datamaskinprojektet/PCB/main_schematic/Grafikk/main_schematic-brd.png

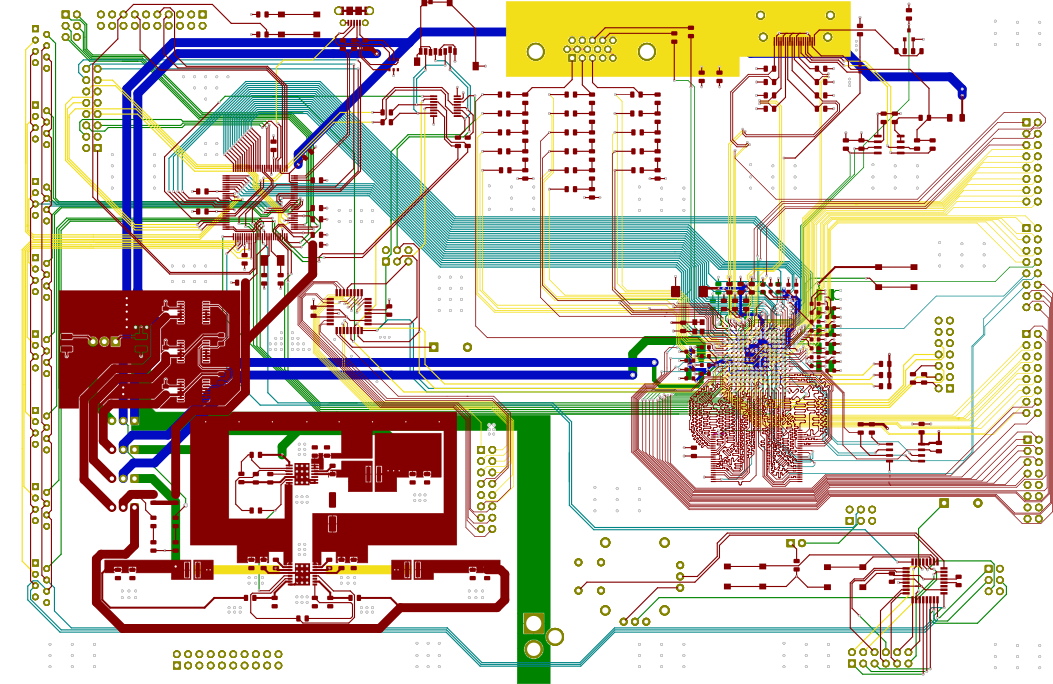
main_schematic/Grafikk/main_schematic-brd.png
