datamaskinprojektet/PCB/README.md

## Useful links:
[Kicad Library mangement](https://hackaday.com/2017/05/18/kicad-best-practises-library-management/)
[Kicad git integration](https://jnavila.github.io/plotkicadsch/)
