datamaskinprojektet/PCB/harwareTest/harwareTest.runs/impl_1/.init_design.begin.rst

<?xml version="1.0"?>
<ProcessHandle Version="1" Minor="0">
    <Process Command=".planAhead." Owner="Viktor" Host="DESKTOP-4Q16636" Pid="52436">
    </Process>
</ProcessHandle>
