datamaskinprojektet/PCB/Controller/Controller/ControllerTop.stl

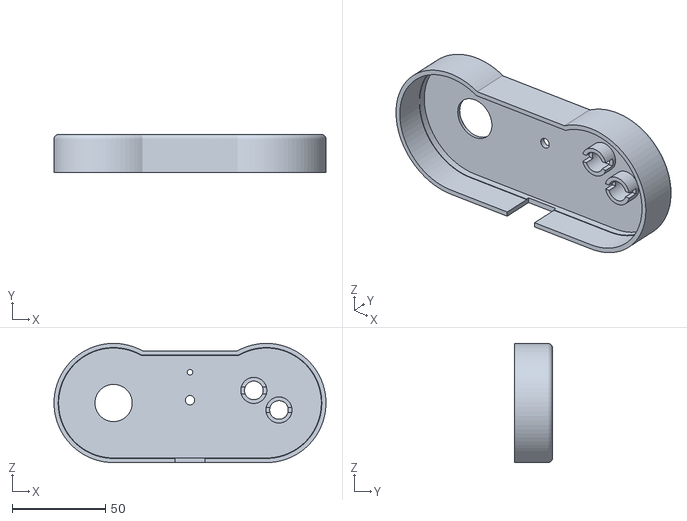
[picture p2: CAD file, 2020-11-24]
Controller/Controller/ControllerTop.stl
146.0 x 20.5 x 64.0
