datamaskinprojektet/PCB/ControllerBetterPrint.stl

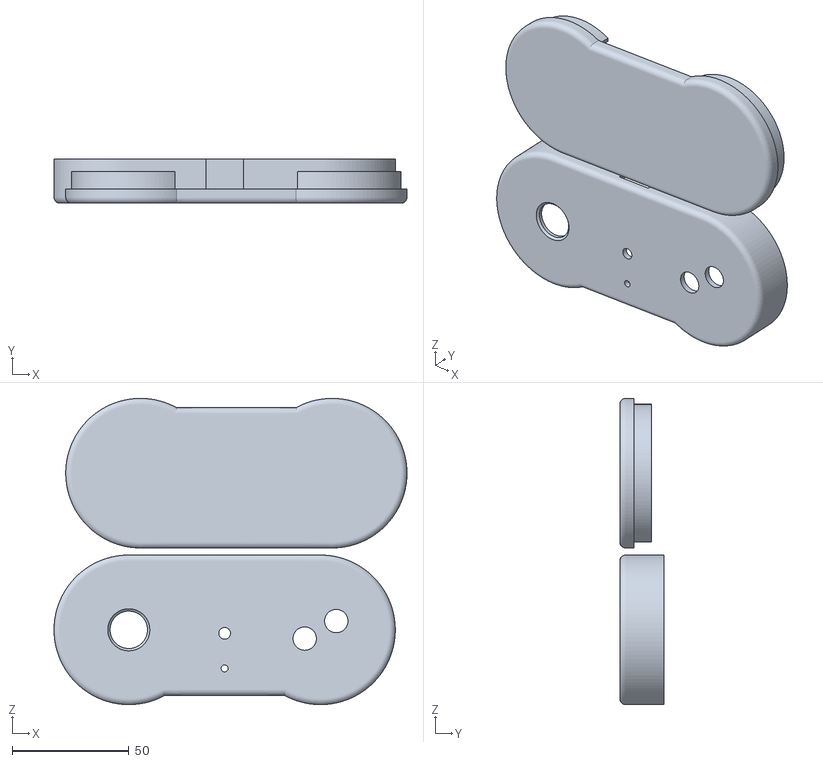
[picture p3: CAD file, 2020-11-24]
ControllerBetterPrint.stl
151.0 x 19.0 x 131.0
