datamaskinprojektet/PCB/main_schematic/SparkFun Lib/step/9032.STEP

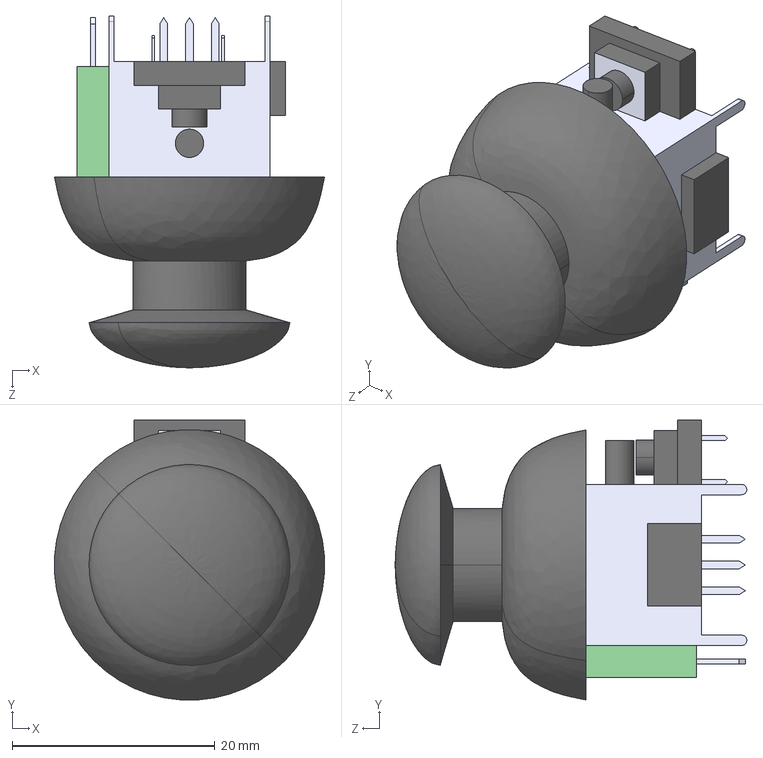
[picture p4: CAD file, 2020-11-24]
main_schematic/SparkFun Lib/step/9032.STEP
26.6 x 27.6 x 34.7 mm
