datamaskinprojektet/PCB/Controller/Controller/Controller_bottom.stl

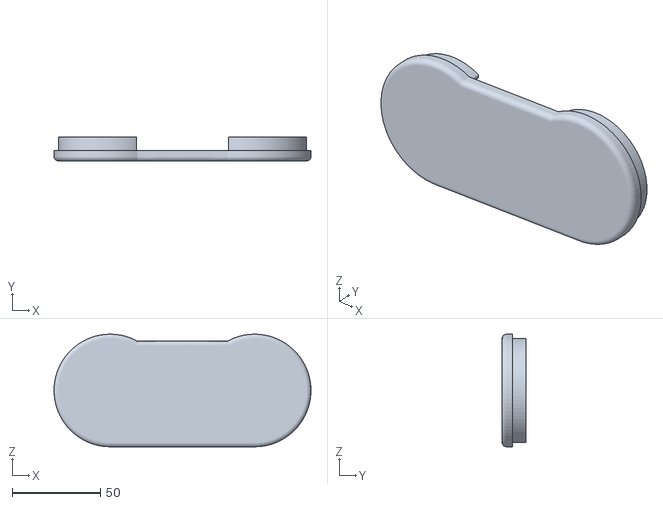
[picture p5: CAD file, 2020-11-24]
Controller/Controller/Controller_bottom.stl
146.0 x 13.5 x 64.0
