datamaskinprojektet/PCB/ControllerTOP.stl

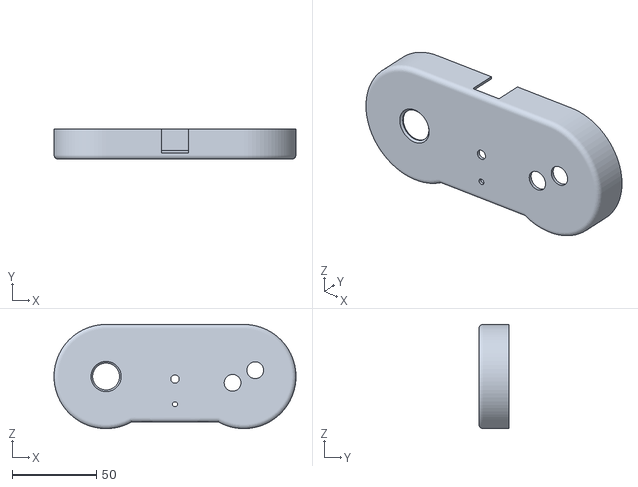
[picture p6: CAD file, 2020-11-24]
ControllerTOP.stl
144.0 x 18.0 x 62.0
