datamaskinprojektet/PCB/Controller/Controller/Abutton.stl

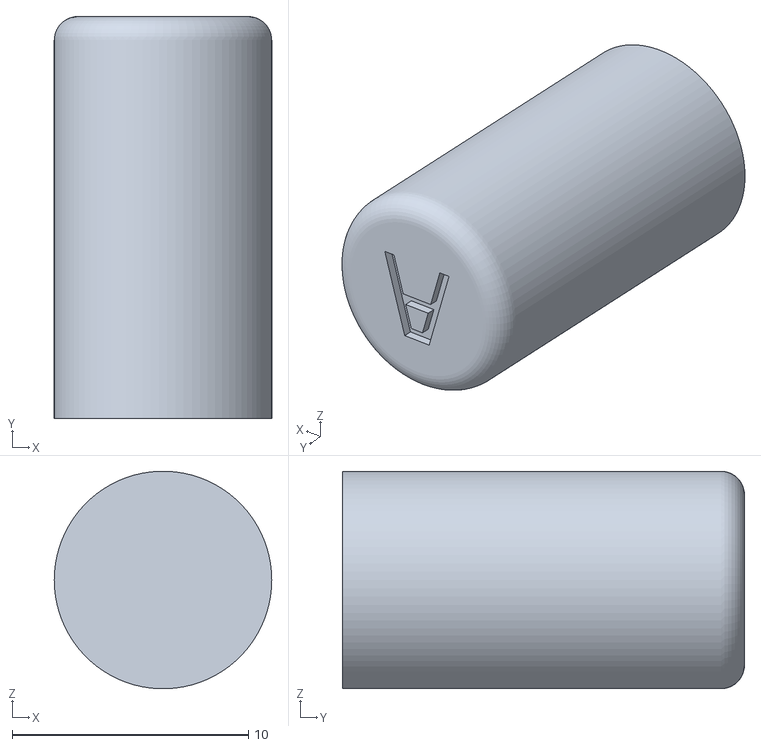
[picture p7: CAD file, 2020-11-24]
Controller/Controller/Abutton.stl
9.20 x 17.0 x 9.19
