datamaskinprojektet/PCB/LoddeDypper v7.stl

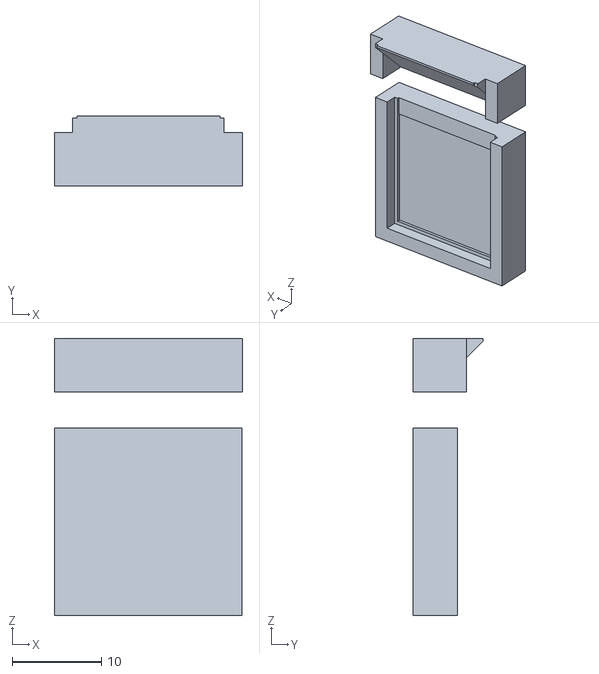
[picture p8: CAD file, 2020-11-24]
LoddeDypper v7.stl
21.0 x 7.85 x 31.0
