datamaskinprojektet/PCB/Controller/Controller/shroud.stl

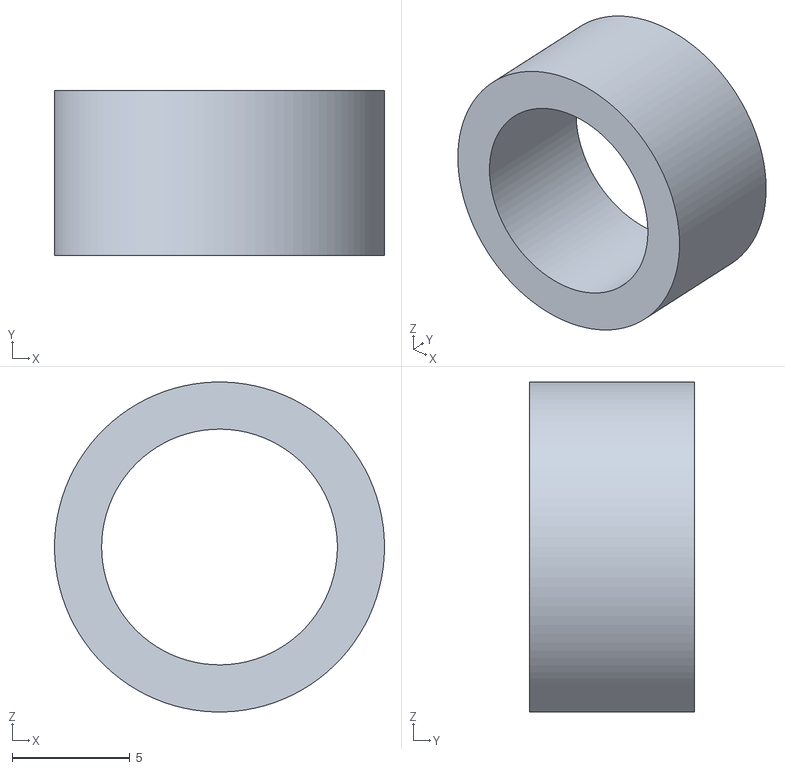
[picture p9: CAD file, 2020-11-24]
Controller/Controller/shroud.stl
14.0 x 7.00 x 14.0
