datamaskinprojektet/PCB/ControllerBOTTOM.stl

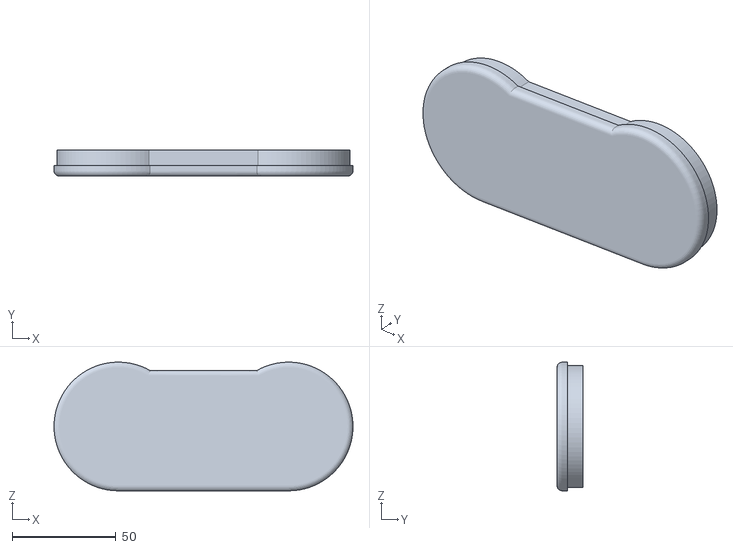
[picture p10: CAD file, 2020-11-24]
ControllerBOTTOM.stl
144.0 x 12.5 x 62.0
