datamaskinprojektet/PCB/Controller v5.stl

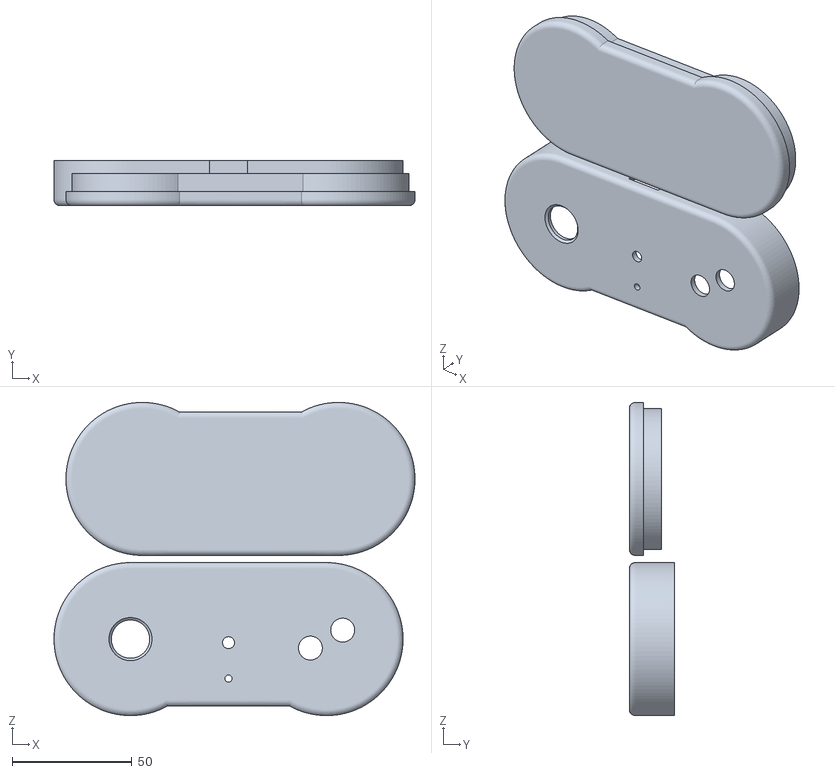
[picture p11: CAD file, 2020-11-24]
Controller v5.stl
151.0 x 19.0 x 131.0
