datamaskinprojektet/PCB/FTG256 v2.stl

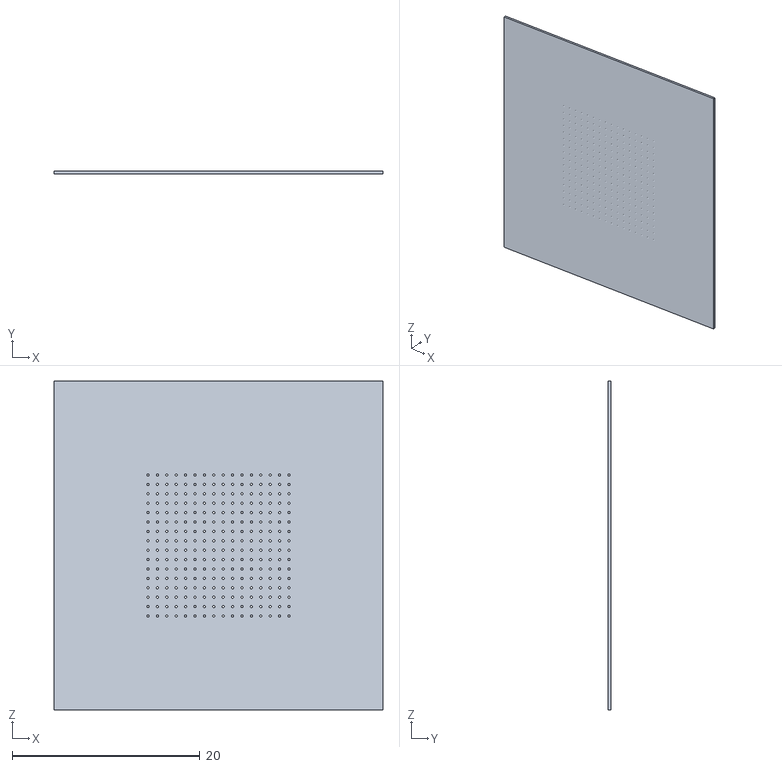
[picture p12: CAD file, 2020-11-05]
FTG256 v2.stl
35.0 x 0.3 x 35.0
