datamaskinprojektet/PCB/Controller v4.stl

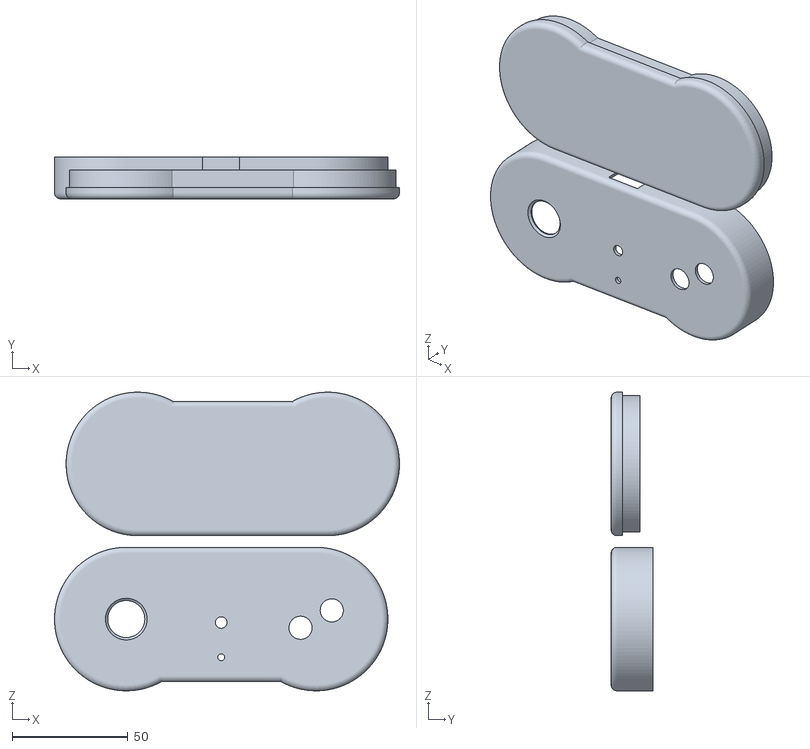
[picture p13: CAD file, 2020-11-24, an earlier design]
Controller v4.stl
149.0 x 18.0 x 129.0
