datamaskinprojektet/PCB/FTG256 v1.stl

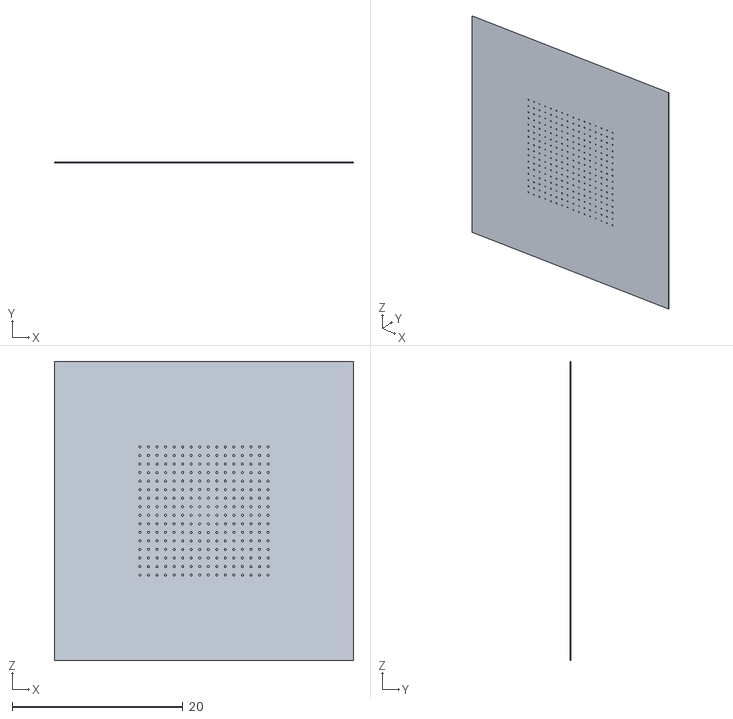
[picture p14: CAD file, 2020-11-05, an earlier design]
FTG256 v1.stl
35.0 x 0.1 x 35.0
