datamaskinprojektet/PCB/LoddeDypper v1.stl

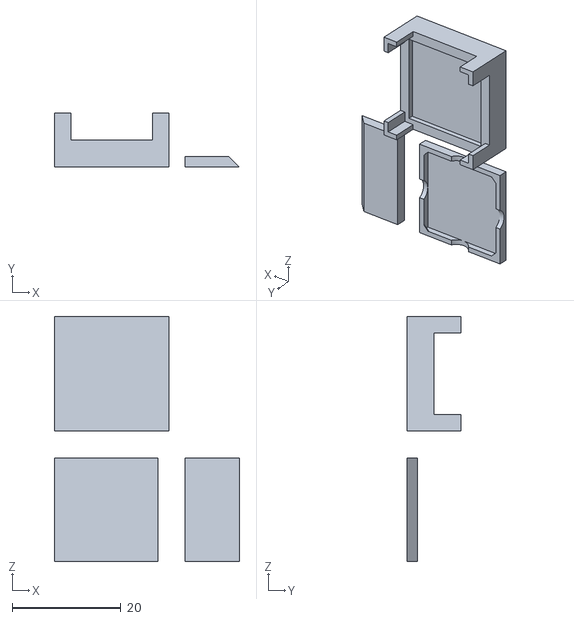
[picture p15: CAD file, 2020-11-05, an earlier design]
LoddeDypper v1.stl
34.0 x 10.0 x 45.0
