datamaskinprojektet/PCB/LoddeDypper v4.stl

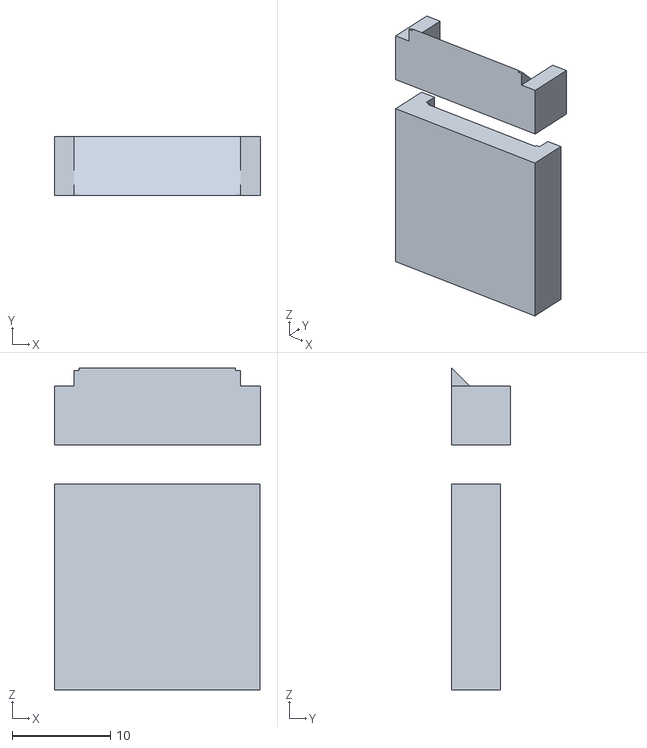
[picture p16: CAD file, 2020-11-05, an earlier design]
LoddeDypper v4.stl
21.0 x 6.00 x 32.9
