datamaskinprojektet/PCB/(list of files, cad)

Other CAD files:
Controller/Controller/Bbutton.stl
LoddeDypper v5.stl
