datamaskinprojektet/PCB/harwareTest/harwareTest.runs/synth_1/.vivado.begin.rst

<?xml version="1.0"?>
<ProcessHandle Version="1" Minor="0">
    <Process Command="vivado.bat" Owner="Viktor" Host="DESKTOP-4Q16636" Pid="46260" HostCore="12" HostMemory="016893956096">
    </Process>
</ProcessHandle>
