datamaskinprojektet/PCB/main_schematic/main_schematic.kicad_pcb

## KiCad design main_schematic/main_schematic.kicad_pcb (2020-11-26)

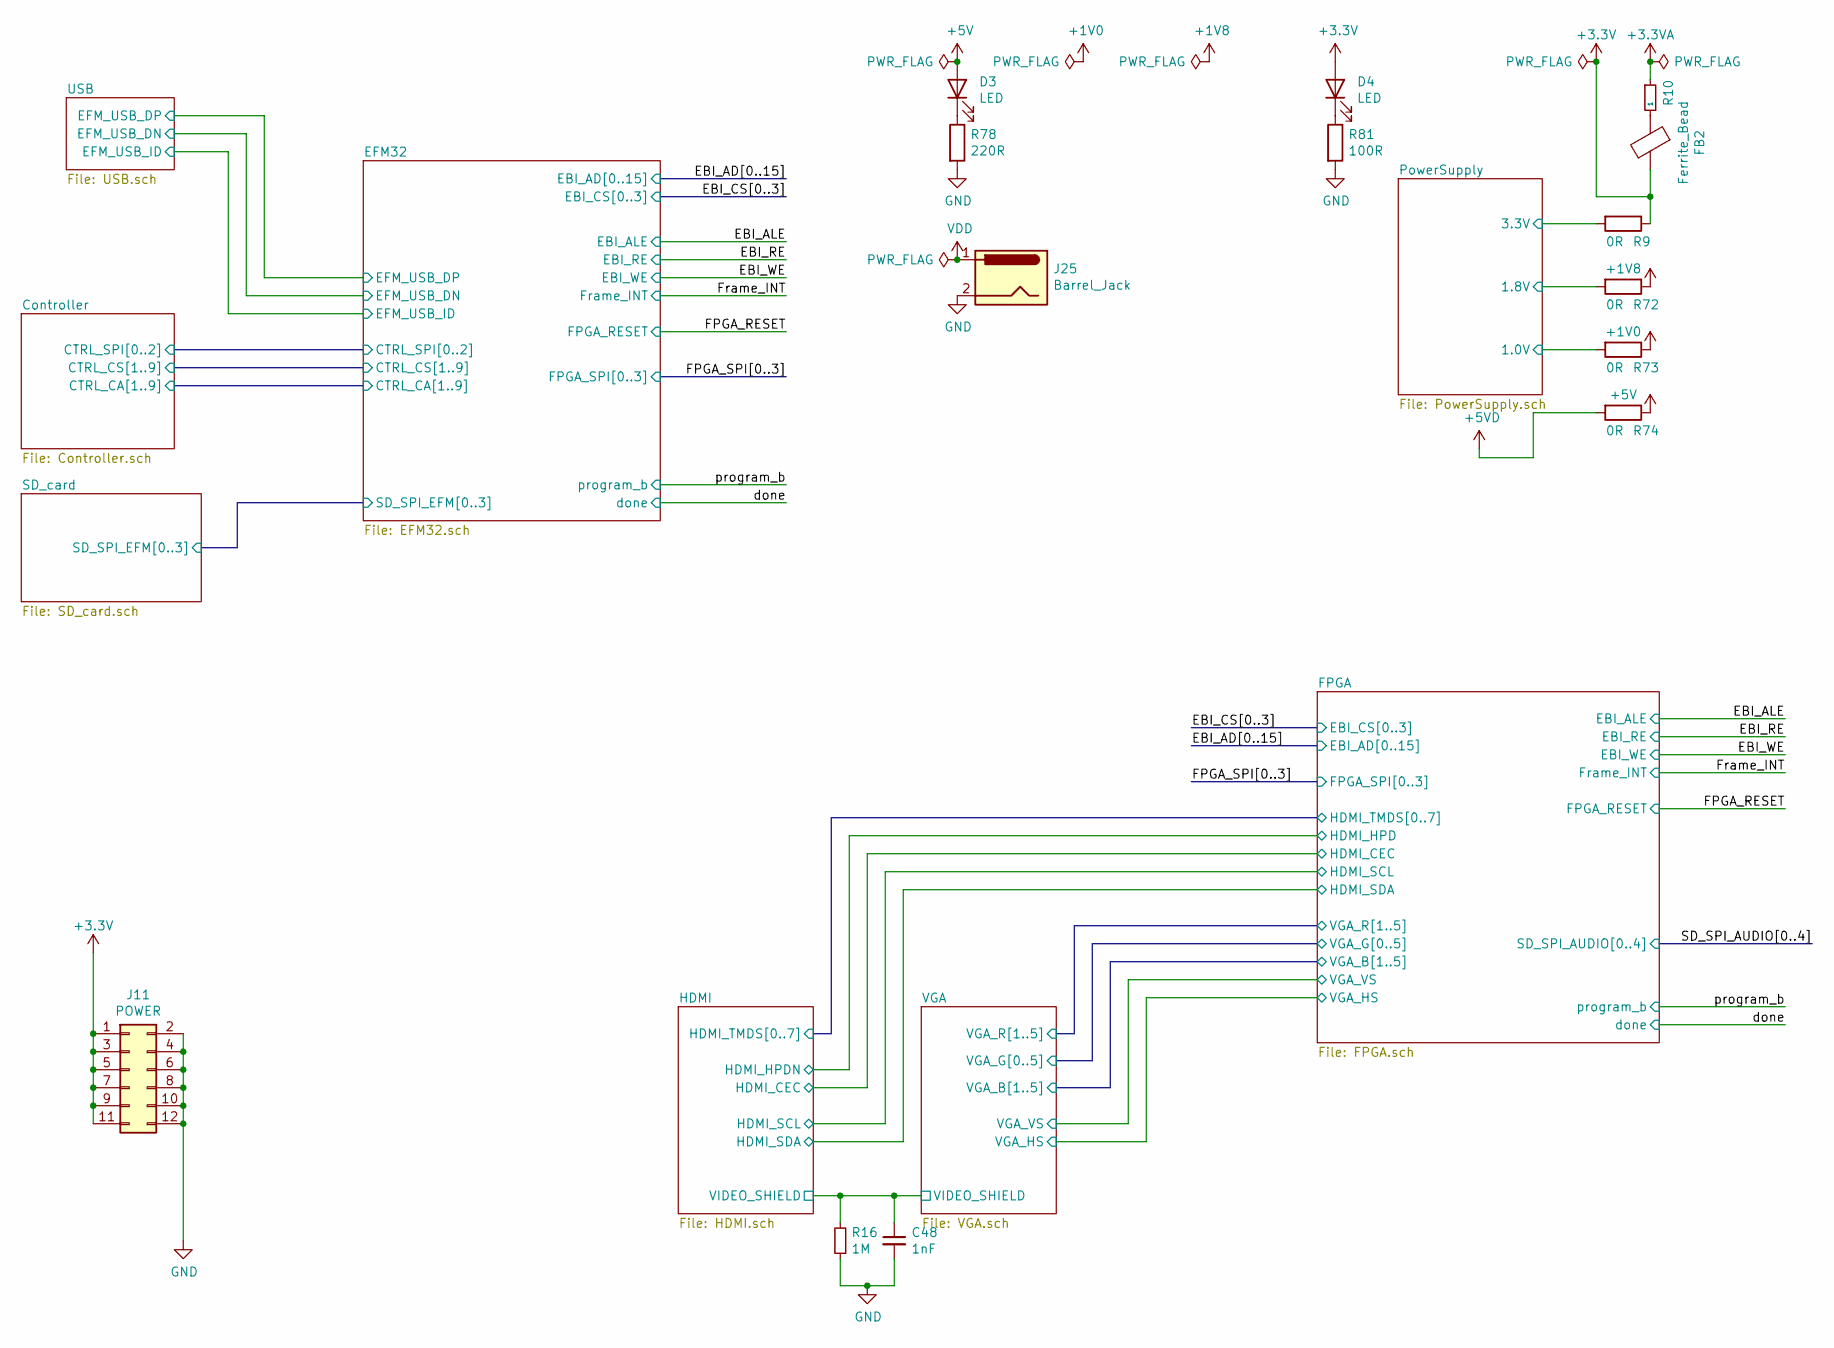
[picture p17: schematic main_schematic.sch]

Parts:
C48: 1nF; C_0805_2012Metric
D3, D4: LED; LED_0805_2012Metric
FB2: Ferrite_Bead; R_0805_2012Metric
J11: POWER; PinSocket_2x06_P2.54mm_Vertical_SMD
J25: Barrel_Jack; BarrelJack_Wuerth_6941xx301002
R9, R72, R73, R74: 0R; R_0805_2012Metric
R10: 1; R_0805_2012Metric
R16: 1M; R_0805_2012Metric
R78: 220R; R_0805_2012Metric
R81: 100R; R_0805_2012Metric

Connections:
+1V0: R73.1; also elsewhere on the board
+1V8: R72.1; also elsewhere on the board
+3.3VA: R10.1; also elsewhere on the board
+5V: D3.2 (A), R74.1; also elsewhere on the board
+5VD: R74.2; also elsewhere on the board
/HDMI/VIDEO_SHIELD: C48.1, R16.2; also elsewhere on the board
/PowerSupply/1.0V: R73.2; also elsewhere on the board
/PowerSupply/1.8V: R72.2; also elsewhere on the board
/PowerSupply/3.3V: R9.2; also elsewhere on the board
GND: C48.2, J11.2, J11.4, J11.6, J11.8, J11.10, J11.12, J25.2, R16.1, R78.2, R81.2; also elsewhere on the board
unnamed: D3.1 (K), R78.1
unnamed: D4.1 (K), R81.1
unnamed: FB2.1, R10.2
VDD: J25.1; also elsewhere on the board

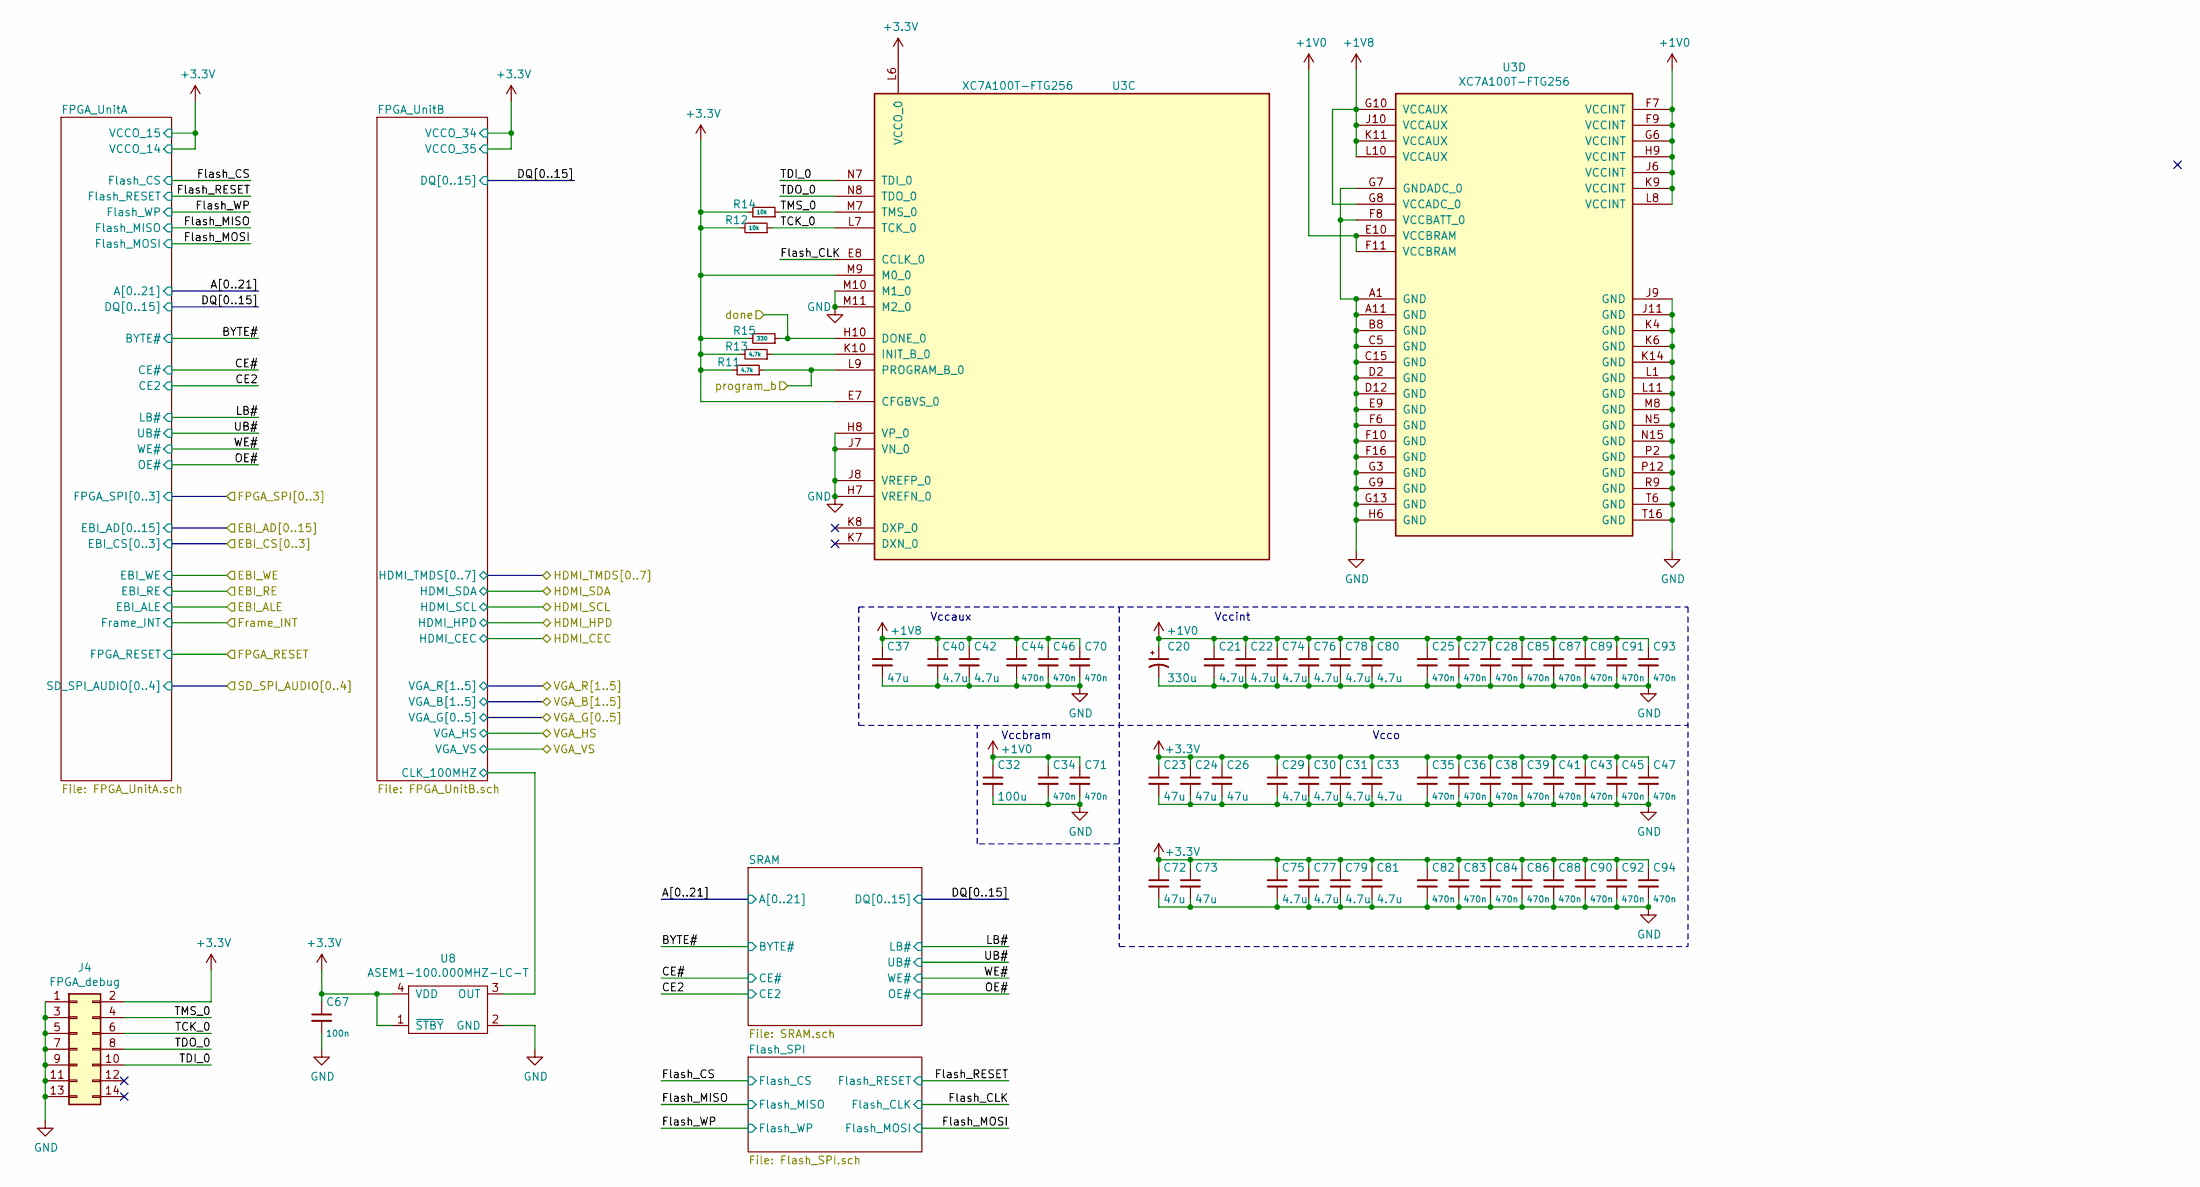
[picture p18: schematic FPGA.sch]

Parts:
C20: 330u; CP_EIA-7343-20_Kemet-V
C21, C22, C29, C30, C31, C33, C40, C42, C74, C75, C76, C77, C78, C79, C80, C81: 4.7u; C_0805_2012Metric
C23, C24, C26, C37, C72, C73: 47u; C_1210_3225Metric
C25, C27, C28, C34, C35, C36, C38, C39, C41, C43, C44, C45, C46, C47, C70, C71, C82, C83, C84, C85, C86, C87, C88, C89, C90, C91, C92, C93, C94: 470n; C_0603_1608Metric
C32: 100u; C_1210_3225Metric
C67: 100n; C_0805_2012Metric
J4: FPGA_debug; PinHeader_2x07_P2.00mm_Vertical_SMD
R11, R13: 4.7k; R_0805_2012Metric
R12, R14: 10k; R_0805_2012Metric
R15: 330; R_0805_2012Metric
U3: XC7A100T-FTG256; Xilinx_FTG256
U8: ASEM1-100.000MHZ-LC-T; Oscillator_SMD_Abracon_ASE-4Pin_3.2x2.5mm

Connections:
+1V0: C20.1, C21.1, C22.1, C25.1, C27.1, C28.1, C32.1, C34.1, C71.1, C74.1, C76.1, C78.1, C80.1, C85.1, C87.1, C89.1, C91.1, C93.1, U3.E10 (VCCBRAM), U3.F7 (VCCINT), U3.F9 (VCCINT), U3.F11 (VCCBRAM), U3.G6 (VCCINT), U3.H9 (VCCINT), U3.J6 (VCCINT), U3.K9 (VCCINT), U3.L8 (VCCINT); also elsewhere on the board
+1V8: C37.1, C40.1, C42.1, C44.1, C46.1, C70.1, U3.G8 (VCCADC_0), U3.G10 (VCCAUX), U3.J10 (VCCAUX), U3.K11 (VCCAUX), U3.L10 (VCCAUX); also elsewhere on the board
/FPGA/FPGA_UnitB/CLK_100MHZ: U8.3 (OUT); also elsewhere on the board
/FPGA/Flash_CLK: U3.E8 (CCLK_0); also elsewhere on the board
/FPGA/TCK_0: J4.6, R12.1, U3.L7 (TCK_0)
/FPGA/TDI_0: J4.10, U3.N7 (TDI_0)
/FPGA/TDO_0: J4.8, U3.N8 (TDO_0)
/FPGA/TMS_0: J4.4, R14.1, U3.M7 (TMS_0)
/done: R15.1, U3.H10 (DONE_0); also elsewhere on the board
/program_b: R11.1, U3.L9 (PROGRAM_B_0); also elsewhere on the board
GND: C20.2, C21.2, C22.2, C23.2, C24.2, C25.2, C26.2, C27.2, C28.2, C29.2, C30.2, C31.2, C32.2, C33.2, C34.2, C35.2, C36.2, C37.2, C38.2, C39.2, C40.2, C41.2, C42.2, C43.2, C44.2, C45.2, C46.2, C47.2, C67.2, C70.2, C71.2, C72.2, C73.2, C74.2, C75.2, C76.2, C77.2, C78.2, C79.2, C80.2, C81.2, C82.2, C83.2, C84.2, C85.2, C86.2, C87.2, C88.2, C89.2, C90.2, C91.2, C92.2, C93.2, C94.2, J4.1, J4.3, J4.5, J4.7, J4.9, J4.11, J4.13, U3.A1 (GND), U3.A11 (GND), U3.B8 (GND), U3.C5 (GND), U3.C15 (GND), U3.D2 (GND), U3.D12 (GND), U3.E9 (GND), U3.F6 (GND), U3.F8 (VCCBATT_0), U3.F10 (GND), U3.F16 (GND), U3.G3 (GND), U3.G7 (GNDADC_0), U3.G9 (GND), U3.G13 (GND), U3.H6 (GND), U3.H7 (VREFN_0), U3.H8 (VP_0), U3.J7 (VN_0), U3.J8 (VREFP_0), U3.J9 (GND), U3.J11 (GND), U3.K4 (GND), U3.K6 (GND), U3.K14 (GND), U3.L1 (GND), U3.L11 (GND), U3.M8 (GND), U3.M10 (M1_0), U3.M11 (M2_0), U3.N5 (GND), U3.N15 (GND), U3.P2 (GND), U3.P12 (GND), U3.R9 (GND), U3.T6 (GND), U3.T16 (GND), U8.2 (GND); also elsewhere on the board
unnamed: R13.1, U3.K10 (INIT_B_0)

Notes on the sheet:
Vccaux
Vccbram
Vccint
Vcco

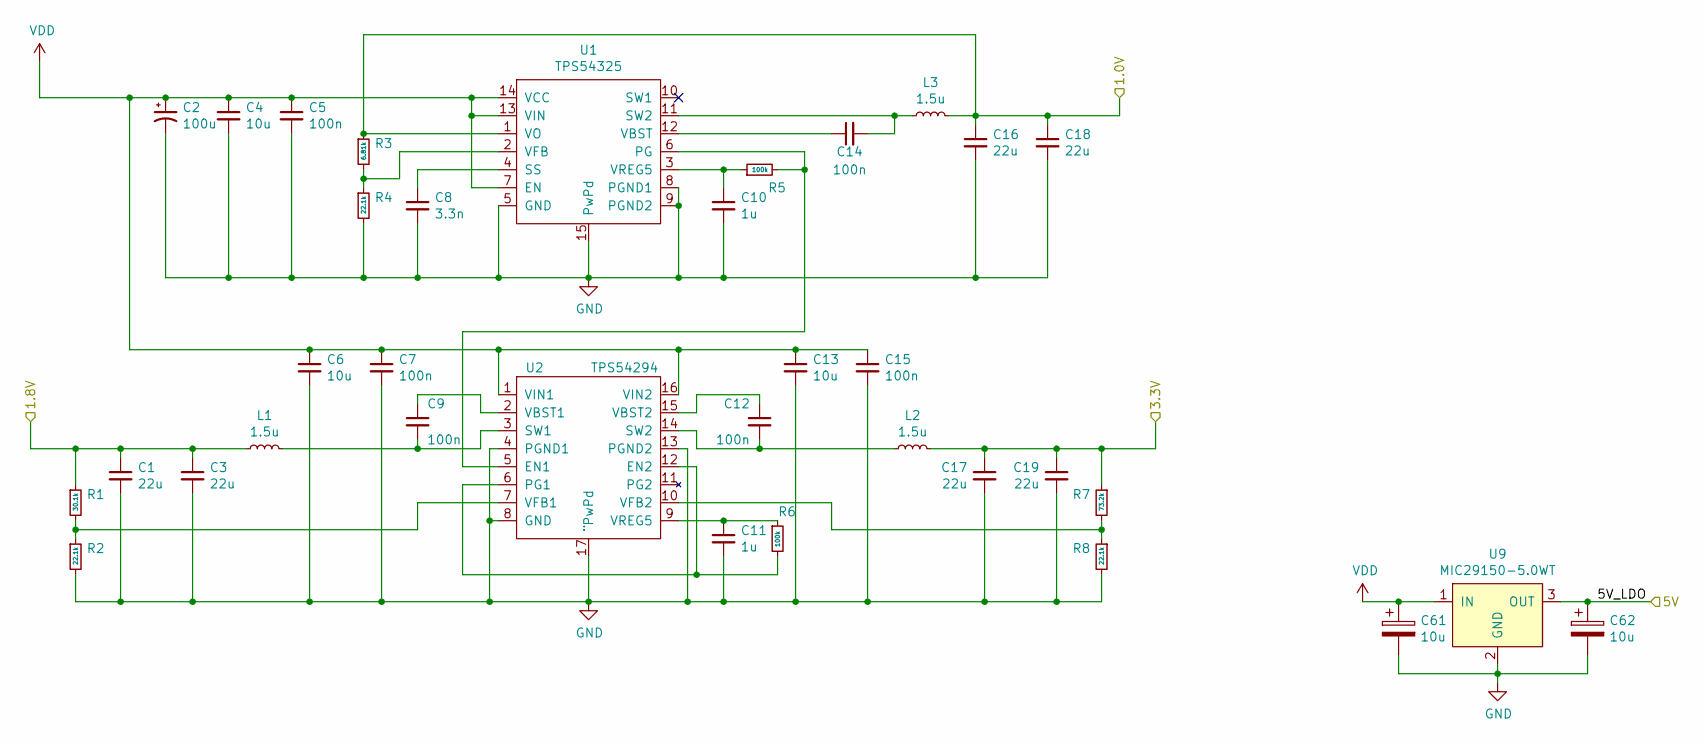
[picture p19: schematic PowerSupply.sch]

Parts:
C1, C3, C16, C17, C18, C19: 22u; C_0805_2012Metric
C2: 100u; CP_Elec_6.3x7.7
C4, C6, C13: 10u; C_0805_2012Metric
C5, C7, C9, C12, C14, C15: 100n; C_0805_2012Metric
C8: 3.3n; C_0805_2012Metric
C10, C11: 1u; C_0805_2012Metric
C61, C62: 10u; C_1210_3225Metric
L1, L2, L3: 1.5u; L_Coilcraft_XxL4020
R1: 30.1k; R_0805_2012Metric
R2, R4, R8: 22.1k; R_0805_2012Metric
R3: 6.81k; R_0805_2012Metric
R5, R6: 100k; R_0805_2012Metric
R7: 73.2k; R_0805_2012Metric
U1: TPS54325; HTSSOP-14-1EP_4.4x5mm_P0.65mm_EP3.4x5mm_Mask3x3.1mm
U2: TPS54294; HTSSOP-16-1EP_4.4x5mm_P0.65mm_EP3.4x5mm
U9: MIC29150-5.0WT; TO-220-3_Horizontal_TabUp

Connections:
/PowerSupply/1.0V: C16.1, C18.1, L3.2, R3.1, U1.1 (VO); also elsewhere on the board
/PowerSupply/1.8V: C1.1, C3.1, L1.1, R1.1; also elsewhere on the board
/PowerSupply/3.3V: C17.1, C19.1, L2.1, R7.1; also elsewhere on the board
/PowerSupply/5V: C62.1, U9.3 (OUT)
GND: C1.2, C2.2, C3.2, C4.2, C5.2, C6.2, C7.2, C8.2, C10.2, C11.2, C13.2, C15.2, C16.2, C17.2, C18.2, C19.2, C61.2, C62.2, R2.2, R4.2, R8.2, U1.5 (GND), U1.8 (PGND1), U1.9 (PGND2), U1.15 (PwPd), U2.4 (PGND1), U2.8 (GND), U2.13 (PGND2), U2.17 (¨PwPd), U9.2 (GND); also elsewhere on the board
unnamed: C8.1, U1.4 (SS)
unnamed: C9.1, U2.2 (VBST1)
unnamed: C9.2, L1.2, U2.3 (SW1)
unnamed: C10.1, R5.1, U1.3 (VREG5)
unnamed: C11.1, R6.1, U2.9 (VREG5)
unnamed: C12.1, U2.15 (VBST2)
unnamed: C12.2, L2.2, U2.14 (SW2)
unnamed: C14.1, U1.12 (VBST)
unnamed: C14.2, L3.1, U1.11 (SW2)
unnamed: R1.2, R2.1, U2.7 (VFB1)
unnamed: R3.2, R4.1, U1.2 (VFB)
unnamed: R5.2, U1.6 (PG), U2.5 (EN1)
unnamed: R6.2, U2.6 (PG1), U2.12 (EN2)
unnamed: R7.2, R8.1, U2.10 (VFB2)
VDD: C2.1, C4.1, C5.1, C6.1, C7.1, C13.1, C15.1, C61.1, U1.7 (EN), U1.13 (VIN), U1.14 (VCC), U2.1 (VIN1), U2.16 (VIN2), U9.1 (IN); also elsewhere on the board

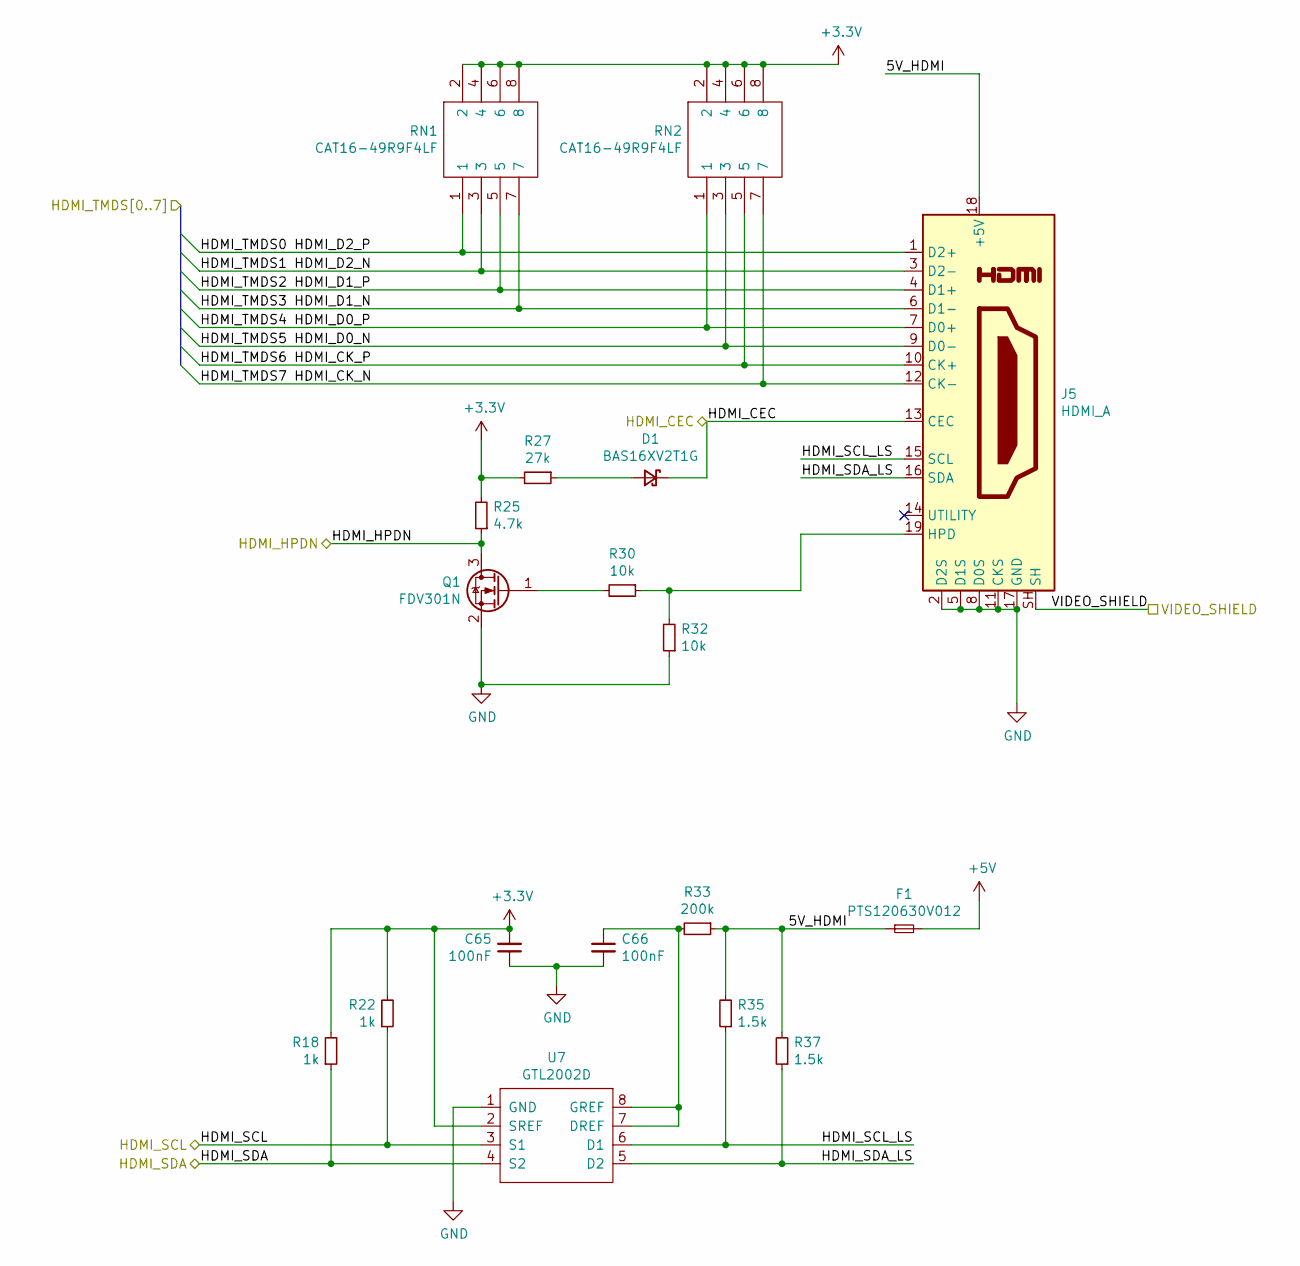
[picture p20: schematic HDMI.sch]

Parts:
C65, C66: 100nF; C_0805_2012Metric
D1: BAS16XV2T1G; D_SOD-523
F1: PTS120630V012; Fuse_1206_3216Metric
J5: HDMI_A; HDMI-10029449-111RLF
Q1: FDV301N; SOT-23
R18, R22: 1k; R_0805_2012Metric
R25: 4.7k; R_0805_2012Metric
R27: 27k; R_0805_2012Metric
R30, R32: 10k; R_0805_2012Metric
R33: 200k; R_0805_2012Metric
R35, R37: 1.5k; R_0805_2012Metric
RN1, RN2: CAT16-49R9F4LF; CAT16104J4LF; Mouser Part Number 652-CAT16-49R9F4LF
U7: GTL2002D; SO-8_3.9x4.9mm_P1.27mm

Connections:
+5V: F1.2; also elsewhere on the board
/FPGA/HDMI_CEC: D1.1 (K), J5.13 (CEC); also elsewhere on the board
/FPGA/HDMI_HPD: Q1.3 (D), R25.1; also elsewhere on the board
/FPGA/HDMI_SCL: R22.1, U7.3 (S1); also elsewhere on the board
/FPGA/HDMI_SDA: R18.1, U7.4 (S2); also elsewhere on the board
/HDMI/5V_HDMI: F1.1, J5.18 (+5V), R33.1, R35.2, R37.2
/HDMI/HDMI_CK_N: J5.12 (CK-), RN2.7; also elsewhere on the board
/HDMI/HDMI_CK_P: J5.10 (CK+), RN2.5; also elsewhere on the board
/HDMI/HDMI_D0_N: J5.9 (D0-), RN2.3; also elsewhere on the board
/HDMI/HDMI_D0_P: J5.7 (D0+), RN2.1; also elsewhere on the board
/HDMI/HDMI_D1_N: J5.6 (D1-), RN1.7; also elsewhere on the board
/HDMI/HDMI_D1_P: J5.4 (D1+), RN1.5; also elsewhere on the board
/HDMI/HDMI_D2_N: J5.3 (D2-), RN1.3; also elsewhere on the board
/HDMI/HDMI_D2_P: J5.1 (D2+), RN1.1; also elsewhere on the board
/HDMI/HDMI_SCL_LS: J5.15 (SCL), R35.1, U7.6 (D1)
/HDMI/HDMI_SDA_LS: J5.16 (SDA), R37.1, U7.5 (D2)
/HDMI/VIDEO_SHIELD: J5.SH; also elsewhere on the board
GND: C65.1, C66.2, J5.2 (D2S), J5.5 (D1S), J5.8 (D0S), J5.11 (CKS), J5.17 (GND), Q1.2 (S), R32.1, U7.1 (GND); also elsewhere on the board
unnamed: C66.1, R33.2, U7.7 (DREF), U7.8 (GREF)
unnamed: D1.2 (A), R27.1
unnamed: J5.19 (HPD), R30.1, R32.2
unnamed: Q1.1 (G), R30.2

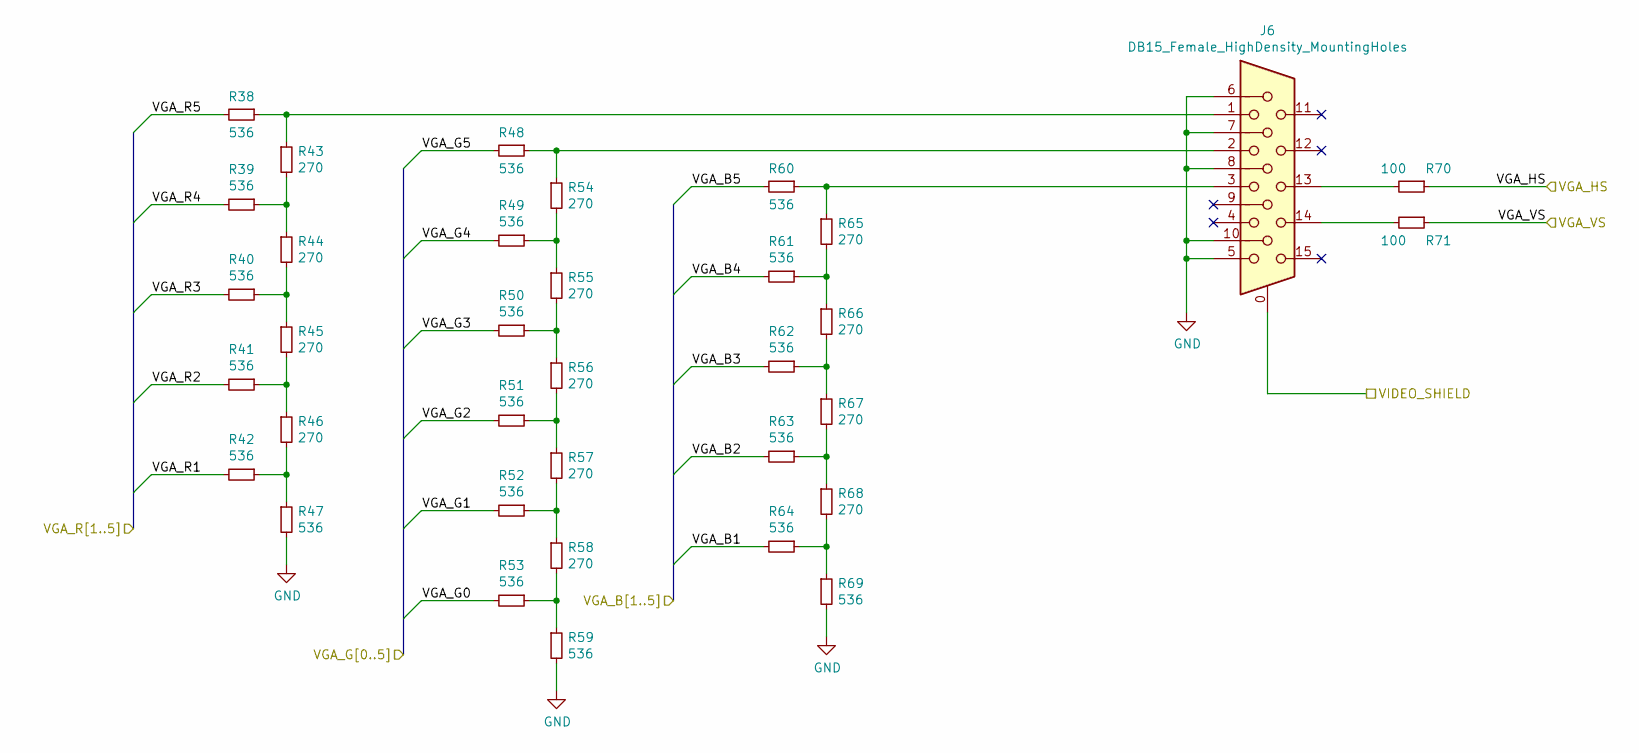
[picture p21: schematic VGA.sch]

Parts:
J6: DB15_Female_HighDensity_MountingHoles; DSUB-15-HD_Female_Horizontal_P2.29x1.98mm_EdgePinOffset8.35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
R38, R39, R40, R41, R42, R47, R48, R49, R50, R51, R52, R53, R59, R60, R61, R62, R63, R64, R69: 536; R_0603_1608Metric
R43, R44, R45, R46, R54, R55, R56, R57, R58, R65, R66, R67, R68: 270; R_0603_1608Metric
R70, R71: 100; R_0805_2012Metric

Connections:
/FPGA/VGA_HS: R70.1; also elsewhere on the board
/FPGA/VGA_VS: R71.1; also elsewhere on the board
/HDMI/VIDEO_SHIELD: J6.0; also elsewhere on the board
/VGA/VGA_B1: R64.2; also elsewhere on the board
/VGA/VGA_B2: R63.2; also elsewhere on the board
/VGA/VGA_B3: R62.2; also elsewhere on the board
/VGA/VGA_B4: R61.2; also elsewhere on the board
/VGA/VGA_B5: R60.2; also elsewhere on the board
/VGA/VGA_G0: R53.2; also elsewhere on the board
/VGA/VGA_G1: R52.2; also elsewhere on the board
/VGA/VGA_G2: R51.2; also elsewhere on the board
/VGA/VGA_G3: R50.2; also elsewhere on the board
/VGA/VGA_G4: R49.2; also elsewhere on the board
/VGA/VGA_G5: R48.2; also elsewhere on the board
/VGA/VGA_R1: R42.2; also elsewhere on the board
/VGA/VGA_R2: R41.2; also elsewhere on the board
/VGA/VGA_R3: R40.2; also elsewhere on the board
/VGA/VGA_R4: R39.2; also elsewhere on the board
/VGA/VGA_R5: R38.2; also elsewhere on the board
GND: J6.5, J6.6, J6.7, J6.8, J6.10, R47.2, R59.2, R69.2; also elsewhere on the board
unnamed: J6.1, R38.1, R43.1
unnamed: J6.2, R48.1, R54.1
unnamed: J6.3, R60.1, R65.1
unnamed: J6.13, R70.2
unnamed: J6.14, R71.2
unnamed: R39.1, R43.2, R44.1
unnamed: R40.1, R44.2, R45.1
unnamed: R41.1, R45.2, R46.1
unnamed: R42.1, R46.2, R47.1
unnamed: R49.1, R54.2, R55.1
unnamed: R50.1, R55.2, R56.1
unnamed: R51.1, R56.2, R57.1
unnamed: R52.1, R57.2, R58.1
unnamed: R53.1, R58.2, R59.1
unnamed: R61.1, R65.2, R66.1
unnamed: R62.1, R66.2, R67.1
unnamed: R63.1, R67.2, R68.1
unnamed: R64.1, R68.2, R69.1

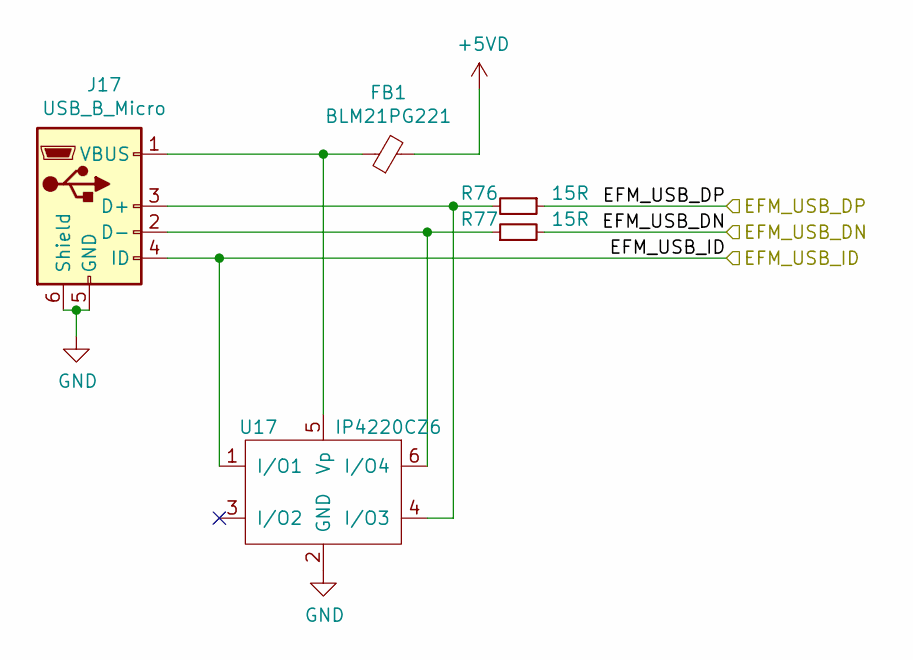
[picture p22: schematic USB.sch]

Parts:
FB1: BLM21PG221; L_0805_2012Metric
J17: USB_B_Micro; USB_Micro-B_Molex-105017-0001
R76, R77: 15R; R_0805_2012Metric
U17: IP4220CZ6; TSOP-6_1.65x3.05mm_P0.95mm

Connections:
+5VD: FB1.2; also elsewhere on the board
/EFM32/EFM_USB_DN: R77.2; also elsewhere on the board
/EFM32/EFM_USB_DP: R76.1; also elsewhere on the board
/EFM32/EFM_USB_ID: J17.4 (ID), U17.1 (I/O1); also elsewhere on the board
GND: J17.5 (GND), J17.6 (Shield), U17.2 (GND); also elsewhere on the board
unnamed: FB1.1, J17.1 (VBUS), U17.5 (Vp)
unnamed: J17.2 (D-), R77.1, U17.6 (I/O4)
unnamed: J17.3 (D+), R76.2, U17.4 (I/O3)
