datamaskinprojektet/PCB/main_schematic/main_schematic.kicad_pcb

## KiCad design main_schematic/main_schematic.kicad_pcb (continued)

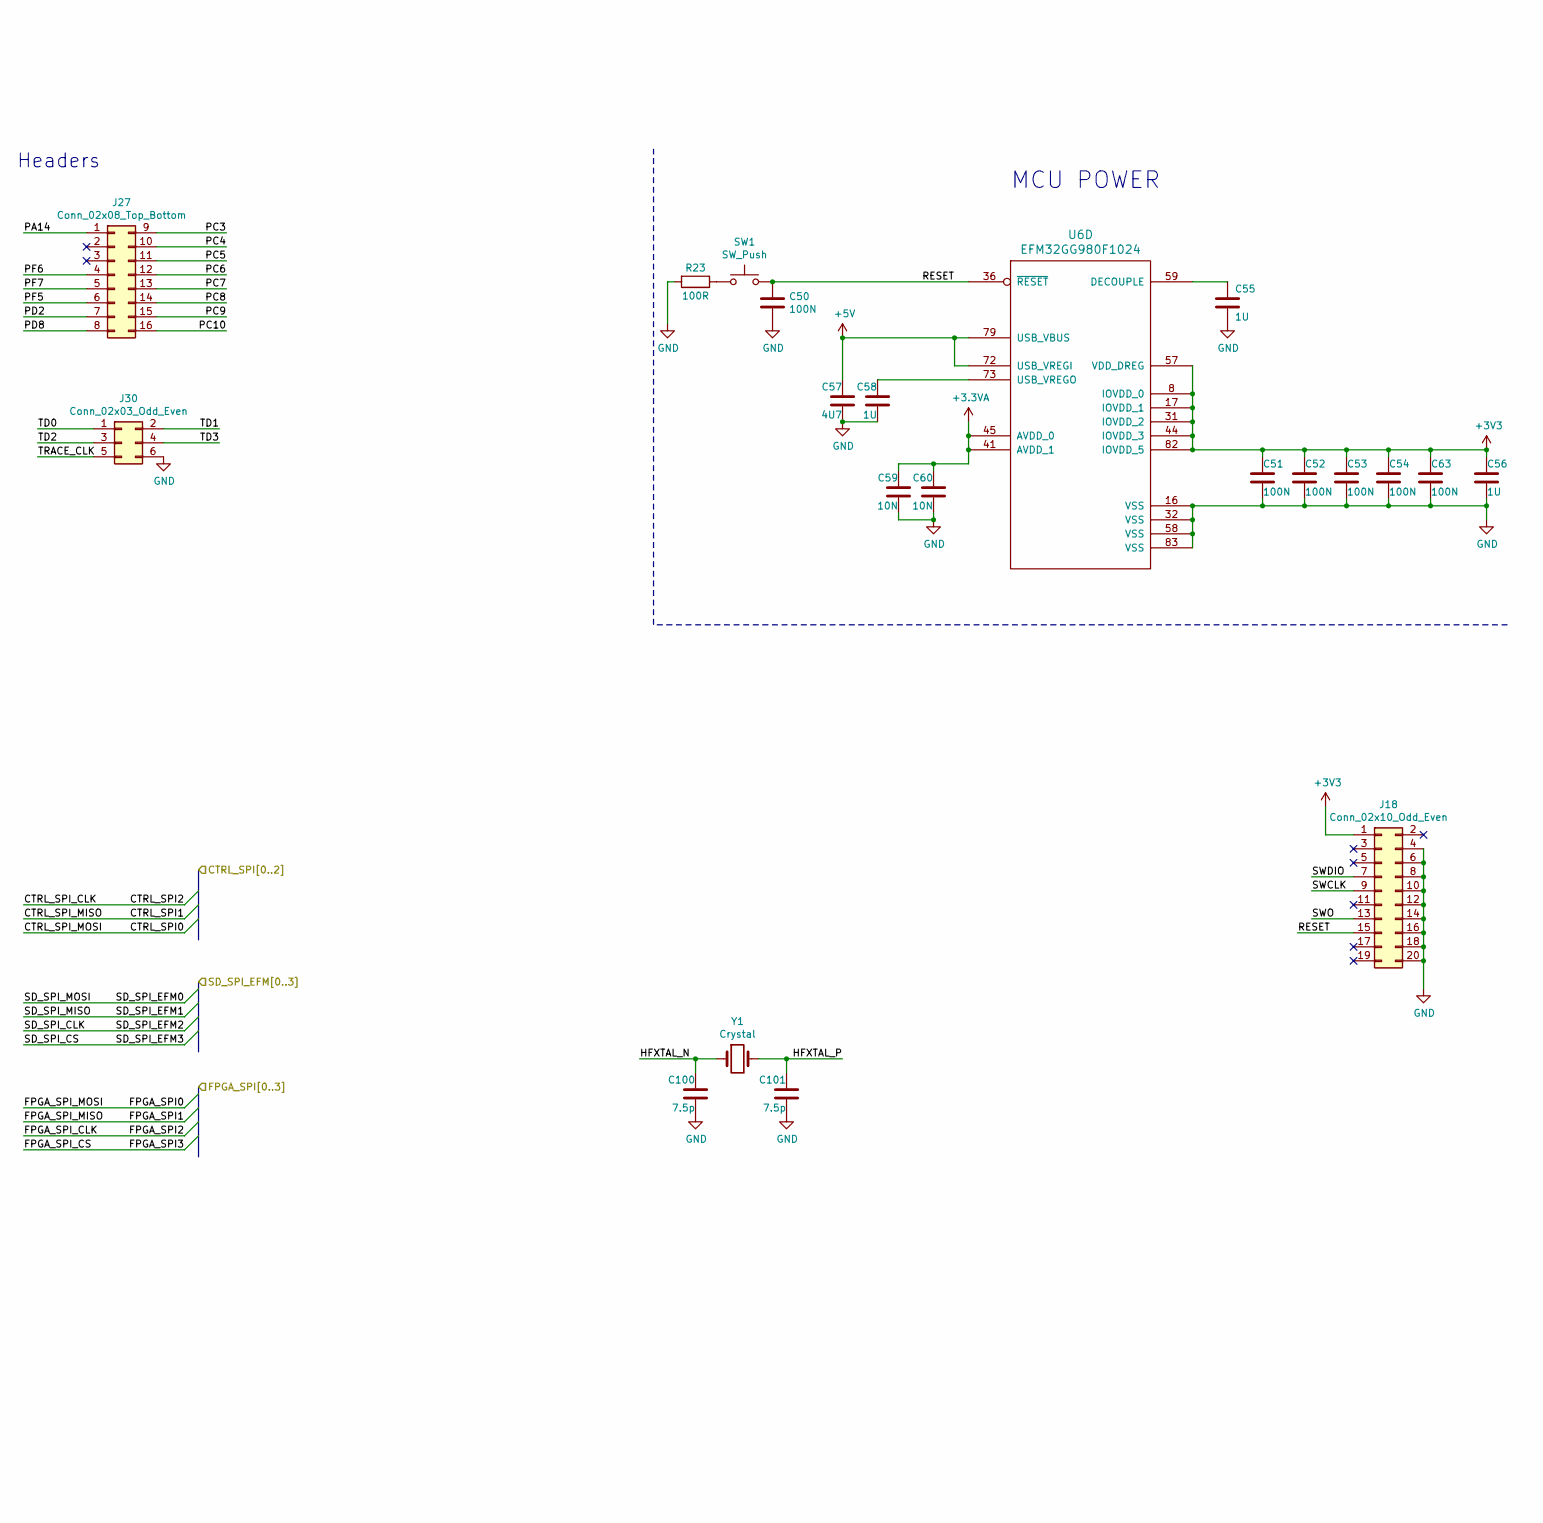
[picture p23: schematic EFM32.sch, part in row 1, column 1]

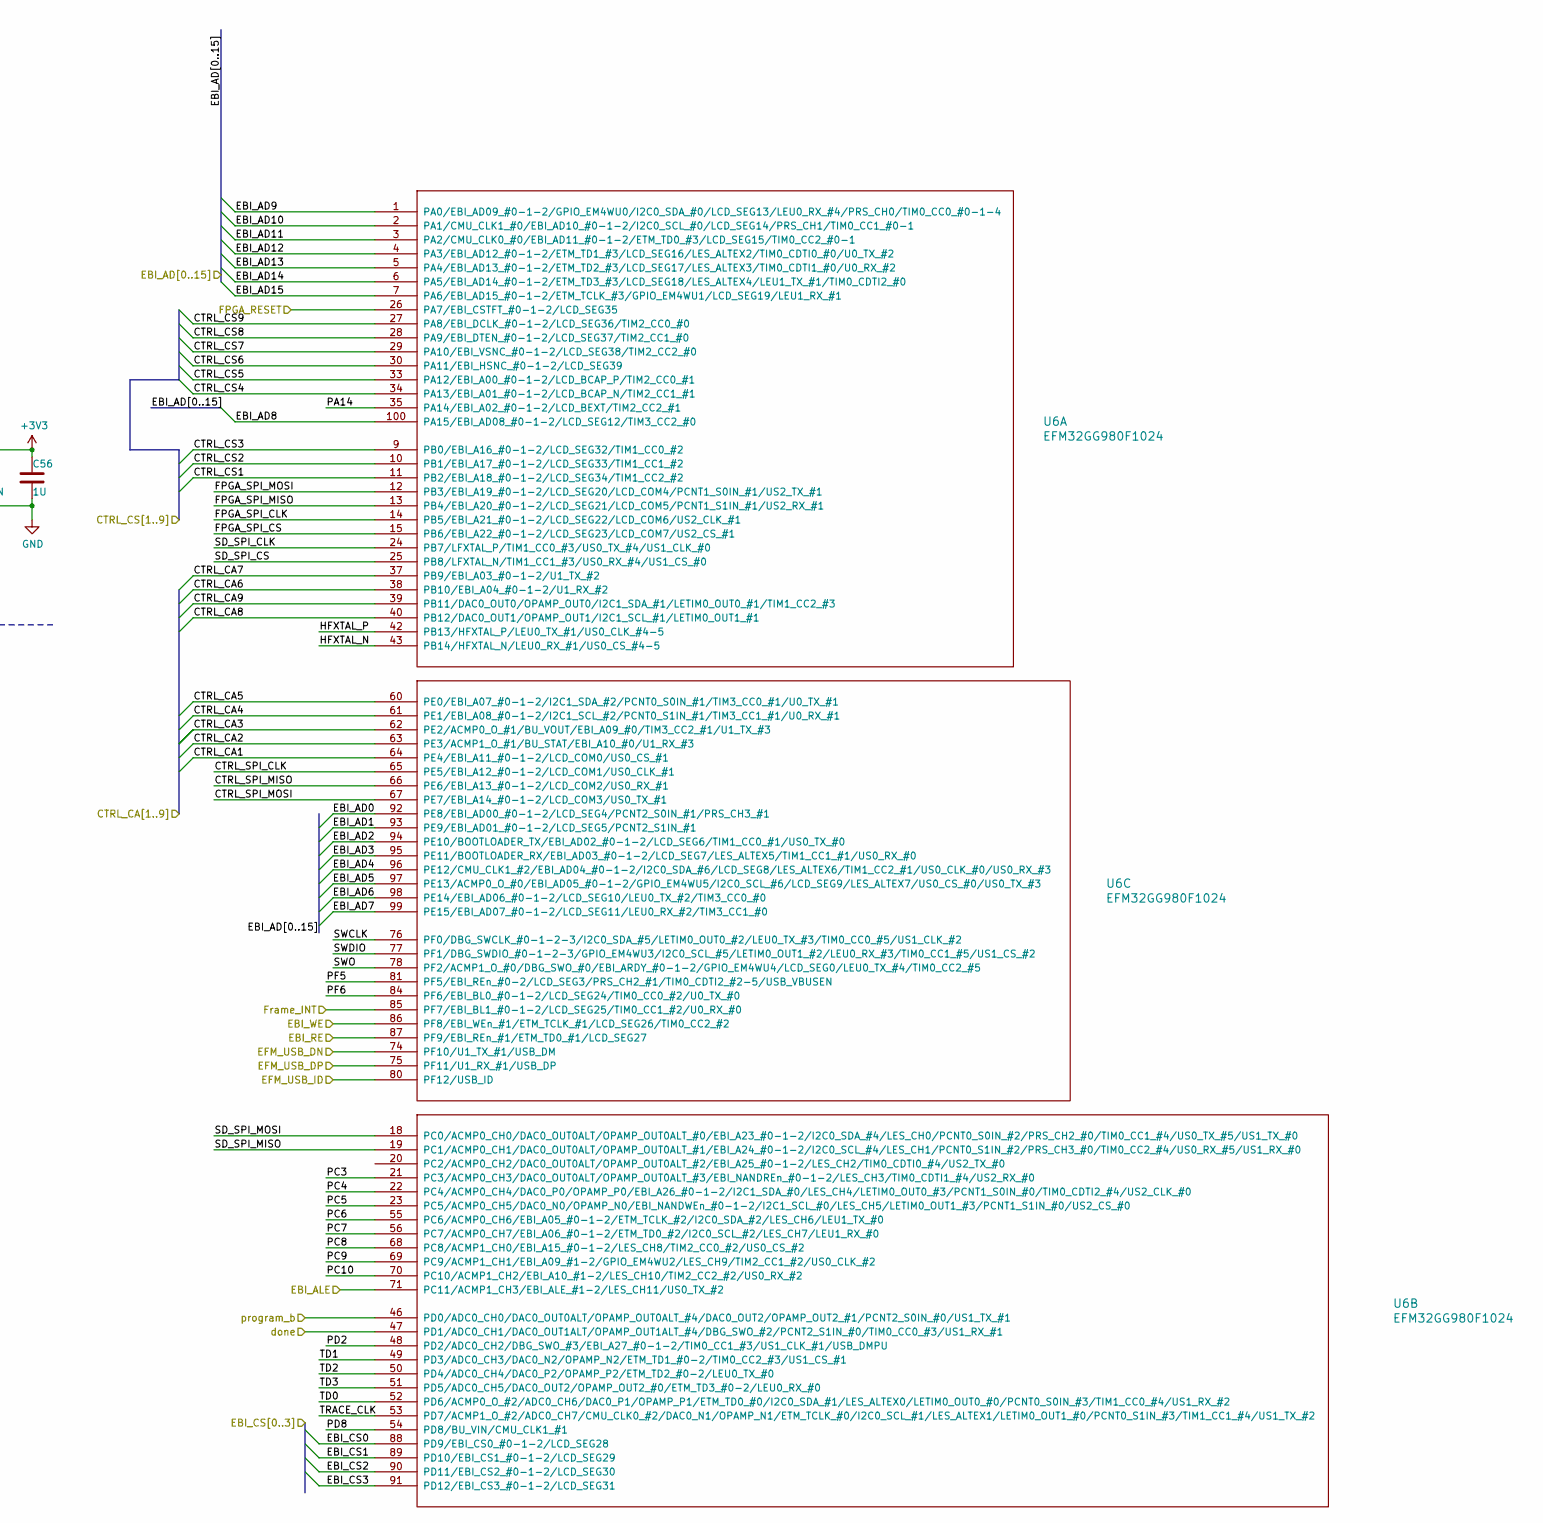
[picture p24: schematic EFM32.sch, part in row 1, column 2]

Parts:
C50, C51, C52, C53, C54, C63: 100N; C_0805_2012Metric
C55, C56, C58: 1U; C_0805_2012Metric
C57: 4U7; C_0805_2012Metric
C59, C60: 10N; C_0805_2012Metric
C100, C101: 7.5p; C_0805_2012Metric
J18: Conn_02x10_Odd_Even; PinHeader_2x10_P2.54mm_Vertical_SMD
J27: Conn_02x08_Top_Bottom; PinHeader_2x08_P2.54mm_Vertical
J30: Conn_02x03_Odd_Even; PinHeader_2x03_P2.54mm_Vertical
R23: 100R; R_0805_2012Metric
SW1: SW_Push; SW_SPST_B3S-1000
U6: EFM32GG980F1024; LQFP-100_14x14mm_P0.5mm
Y1: Crystal; Crystal_SMD_TXC_7A-2Pin_5x3.2mm

Connections:
+3.3VA: C59.1, C60.1, U6.41 (AVDD_1), U6.45 (AVDD_0); also elsewhere on the board
+5V: C57.1, U6.72 (USB_VREGI), U6.79 (USB_VBUS); also elsewhere on the board
/Controller/CTRL_CA1: U6.64 (PE4/EBI_A11_#0-1-2/LCD_COM0/US0_CS_#1); also elsewhere on the board
/Controller/CTRL_CA2: U6.63 (PE3/ACMP1_O_#1/BU_STAT/EBI_A10_#0/U1_RX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); also elsewhere on the board
/Controller/CTRL_CA3: U6.62 (PE2/ACMP0_O_#1/BU_VOUT/EBI_A09_#0/TIM3_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); also elsewhere on the board
/Controller/CTRL_CA4: U6.61 (PE1/EBI_A08_#0-1-2/I2C1_SCL_#2/PCNT0_S1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); also elsewhere on the board
/Controller/CTRL_CS1: U6.11 (PB2/EBI_A18_#0-1-2/LCD_SEG34/TIM1_CC2_#2); also elsewhere on the board
/Controller/CTRL_CS2: U6.10 (PB1/EBI_A17_#0-1-2/LCD_SEG33/TIM1_CC1_#2); also elsewhere on the board
/Controller/CTRL_CS3: U6.9 (PB0/EBI_A16_#0-1-2/LCD_SEG32/TIM1_CC0_#2); also elsewhere on the board
/Controller/CTRL_CS4: U6.34 (PA13/EBI_A01_#0-1-2/LCD_BCAP_N/TIM2_CC1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); also elsewhere on the board
/Controller/CTRL_SPI0: U6.67 (PE7/EBI_A14_#0-1-2/LCD_COM3/US0_TX_#1)
/Controller/CTRL_SPI1: U6.66 (PE6/EBI_A13_#0-1-2/LCD_COM2/US0_RX_#1)
/Controller/CTRL_SPI2: U6.65 (PE5/EBI_A12_#0-1-2/LCD_COM1/US0_CLK_#1)
/EBI_ALE: U6.71 (PC11/ACMP1_CH3/EBI_ALE_#1-2/LES_CH11/US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); also elsewhere on the board
/EBI_RE: U6.87 (PF9/EBI_REn_#1/ETM_TD0_#1/LCD_SEG27); also elsewhere on the board
/EBI_WE: U6.86 (PF8/EBI_WEn_#1/ETM_TCLK_#1/LCD_SEG26/TI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); also elsewhere on the board
/EFM32/CTRL_CA5: U6.60 (PE0/EBI_A07_#0-1-2/I2C1_SDA_#2/PCNT0_S0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)
/EFM32/CTRL_CA6: U6.38 (PB10/EBI_A04_#0-1-2/U1_RX_#2)
/EFM32/CTRL_CA7: U6.37 (PB9/EBI_A03_#0-1-2/U1_TX_#2)
/EFM32/CTRL_CA8: U6.40 (PB12/DAC0_OUT1/OPAMP_OUT1/I2C1_SCL_#1/L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)
/EFM32/CTRL_CA9: U6.39 (PB11/DAC0_OUT0/OPAMP_OUT0/I2C1_SDA_#1/L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)
/EFM32/CTRL_CS5: U6.33 (PA12/EBI_A00_#0-1-2/LCD_BCAP_P/TIM2_CC0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)
/EFM32/CTRL_CS6: U6.30 (PA11/EBI_HSNC_#0-1-2/LCD_SEG39)
/EFM32/CTRL_CS7: U6.29 (PA10/EBI_VSNC_#0-1-2/LCD_SEG38/TIM2_CC2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)
/EFM32/CTRL_CS8: U6.28 (PA9/EBI_DTEN_#0-1-2/LCD_SEG37/TIM2_CC1_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)
/EFM32/CTRL_CS9: U6.27 (PA8/EBI_DCLK_#0-1-2/LCD_SEG36/TIM2_CC0_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)
/EFM32/EBI_AD4: U6.96 (PE12/CMU_CLK1_#2/EBI_AD04_#0-1-2/I2C0_S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); also elsewhere on the board
/EFM32/EBI_AD5: U6.97 (PE13/ACMP0_O_#0/EBI_AD05_#0-1-2/GPIO_EM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); also elsewhere on the board
/EFM32/EBI_AD6: U6.98 (PE14/EBI_AD06_#0-1-2/LCD_SEG10/LEU0_TX_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); also elsewhere on the board
/EFM32/EBI_AD7: U6.99 (PE15/EBI_AD07_#0-1-2/LCD_SEG11/LEU0_RX_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); also elsewhere on the board
/EFM32/EBI_AD8: U6.100 (PA15/EBI_AD08_#0-1-2/LCD_SEG12/TIM3_CC2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); also elsewhere on the board
/EFM32/EBI_AD9: U6.1 (PA0/EBI_AD09_#0-1-2/GPIO_EM4WU0/I2C0_SD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); also elsewhere on the board
/EFM32/EBI_AD10: U6.2 (PA1/CMU_CLK1_#0/EBI_AD10_#0-1-2/I2C0_SC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); also elsewhere on the board
/EFM32/EBI_AD11: U6.3 (PA2/CMU_CLK0_#0/EBI_AD11_#0-1-2/ETM_TD0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); also elsewhere on the board
/EFM32/EBI_AD12: U6.4 (PA3/EBI_AD12_#0-1-2/ETM_TD1_#3/LCD_SEG1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); also elsewhere on the board
/EFM32/EBI_AD13: U6.5 (PA4/EBI_AD13_#0-1-2/ETM_TD2_#3/LCD_SEG1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); also elsewhere on the board
/EFM32/EBI_AD14: U6.6 (PA5/EBI_AD14_#0-1-2/ETM_TD3_#3/LCD_SEG1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); also elsewhere on the board
/EFM32/EBI_AD15: U6.7 (PA6/EBI_AD15_#0-1-2/ETM_TCLK_#3/GPIO_EM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); also elsewhere on the board
/EFM32/EFM_USB_DN: U6.74 (PF10/U1_TX_#1/USB_DM); also elsewhere on the board
/EFM32/EFM_USB_DP: U6.75 (PF11/U1_RX_#1/USB_DP); also elsewhere on the board
/EFM32/EFM_USB_ID: U6.80 (PF12/USB_ID); also elsewhere on the board
/EFM32/FPGA_SPI0: U6.12 (PB3/EBI_A19_#0-1-2/LCD_SEG20/LCD_COM4/P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); also elsewhere on the board
/EFM32/FPGA_SPI1: U6.13 (PB4/EBI_A20_#0-1-2/LCD_SEG21/LCD_COM5/P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); also elsewhere on the board
/EFM32/FPGA_SPI2: U6.14 (PB5/EBI_A21_#0-1-2/LCD_SEG22/LCD_COM6/U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); also elsewhere on the board
/EFM32/FPGA_SPI3: U6.15 (PB6/EBI_A22_#0-1-2/LCD_SEG23/LCD_COM7/U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); also elsewhere on the board
/EFM32/HFXTAL_N: C100.1, U6.43 (PB14/HFXTAL_N/LEU0_RX_#1/US0_CS_#4-5), Y1.1
/EFM32/HFXTAL_P: C101.1, U6.42 (PB13/HFXTAL_P/LEU0_TX_#1/US0_CLK_#4-5), Y1.2
/EFM32/PA14: J27.1, U6.35 (PA14/EBI_A02_#0-1-2/LCD_BEXT/TIM2_CC2_#1)
/EFM32/PC3: J27.9, U6.21 (PC3/ACMP0_CH3/DAC0_OUT0ALT/OPAMP_OUT0AL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)
/EFM32/PC4: J27.10, U6.22 (PC4/ACMP0_CH4/DAC0_P0/OPAMP_P0/EBI_A26_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)
/EFM32/PC5: J27.11, U6.23 (PC5/ACMP0_CH5/DAC0_N0/OPAMP_N0/EBI_NAND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)
/EFM32/PC6: J27.12, U6.55 (PC6/ACMP0_CH6/EBI_A05_#0-1-2/ETM_TCLK_#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)
/EFM32/PC7: J27.13, U6.56 (PC7/ACMP0_CH7/EBI_A06_#0-1-2/ETM_TD0_#2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)
/EFM32/PC8: J27.14, U6.68 (PC8/ACMP1_CH0/EBI_A15_#0-1-2/LES_CH8/TI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)
/EFM32/PC9: J27.15, U6.69 (PC9/ACMP1_CH1/EBI_A09_#1-2/GPIO_EM4WU2/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)
/EFM32/PC10: J27.16, U6.70 (PC10/ACMP1_CH2/EBI_A10_#1-2/LES_CH10/TI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)
/EFM32/PD2: J27.7, U6.48 (PD2/ADC0_CH2/DBG_SWO_#3/EBI_A27_#0-1-2/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)
/EFM32/PD8: J27.8, U6.54 (PD8/BU_VIN/CMU_CLK1_#1)
/EFM32/PF5: J27.6, U6.81 (PF5/EBI_REn_#0-2/LCD_SEG3/PRS_CH2_#1/TI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)
/EFM32/PF6: J27.4, U6.84 (PF6/EBI_BL0_#0-1-2/LCD_SEG24/TIM0_CC0_#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)
/EFM32/PF7: J27.5
/EFM32/RESET: C50.1, J18.15, SW1.2, U6.36 (~RESET~)
/EFM32/SD_SPI_CLK: U6.24 (PB7/LFXTAL_P/TIM1_CC0_#3/US0_TX_#4/US1_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); also elsewhere on the board
/EFM32/SD_SPI_CS: U6.25 (PB8/LFXTAL_N/TIM1_CC1_#3/US0_RX_#4/US1_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); also elsewhere on the board
/EFM32/SD_SPI_EFM0: U6.18 (PC0/ACMP0_CH0/DAC0_OUT0ALT/OPAMP_OUT0AL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); also elsewhere on the board
/EFM32/SD_SPI_EFM1: U6.19 (PC1/ACMP0_CH1/DAC0_OUT0ALT/OPAMP_OUT0AL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); also elsewhere on the board
/EFM32/SWCLK: J18.9, U6.76 (PF0/DBG_SWCLK_#0-1-2-3/I2C0_SDA_#5/LETI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)
/EFM32/SWDIO: J18.7, U6.77 (PF1/DBG_SWDIO_#0-1-2-3/GPIO_EM4WU3/I2C0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)
/EFM32/SWO: J18.13, U6.78 (PF2/ACMP1_O_#0/DBG_SWO_#0/EBI_ARDY_#0-1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)
/EFM32/TD0: J30.1, U6.52 (PD6/ACMP0_O_#2/ADC0_CH6/DAC0_P1/OPAMP_P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)
/EFM32/TD1: J30.2, U6.49 (PD3/ADC0_CH3/DAC0_N2/OPAMP_N2/ETM_TD1_#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)
/EFM32/TD2: J30.3, U6.50 (PD4/ADC0_CH4/DAC0_P2/OPAMP_P2/ETM_TD2_#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)
/EFM32/TD3: J30.4, U6.51 (PD5/ADC0_CH5/DAC0_OUT2/OPAMP_OUT2_#0/ET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)
/EFM32/TRACE_CLK: J30.5, U6.53 (PD7/ACMP1_O_#2/ADC0_CH7/CMU_CLK0_#2/DAC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)
/FPGA_RESET: U6.26 (PA7/EBI_CSTFT_#0-1-2/LCD_SEG35); also elsewhere on the board
/Frame_INT: U6.85 (PF7/EBI_BL1_#0-1-2/LCD_SEG25/TIM0_CC1_#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); also elsewhere on the board
/done: U6.47 (PD1/ADC0_CH1/DAC0_OUT1ALT/OPAMP_OUT1ALT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); also elsewhere on the board
/program_b: U6.46 (PD0/ADC0_CH0/DAC0_OUT0ALT/OPAMP_OUT0ALT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); also elsewhere on the board
GND: C50.2, C51.2, C52.2, C53.2, C54.2, C55.2, C56.2, C57.2, C58.2, C59.2, C60.2, C63.2, C100.2, C101.2, J18.4, J18.6, J18.8, J18.10, J18.12, J18.14, J18.16, J18.18, J18.20, J30.6, R23.2, U6.16 (VSS), U6.32 (VSS), U6.58 (VSS), U6.83 (VSS); also elsewhere on the board
unnamed: C55.1, U6.59 (DECOUPLE)
unnamed: C58.1, U6.73 (USB_VREGO)
unnamed: R23.1, SW1.1

Notes on the sheet:
MCU POWER
Headers

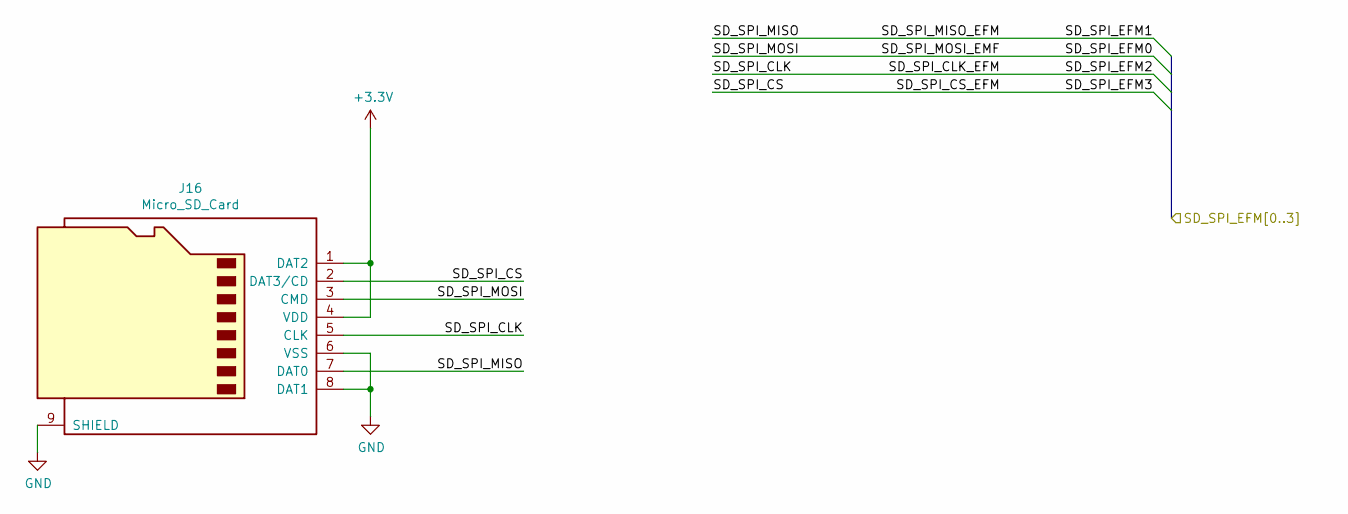
[picture p25: schematic SD_card.sch]

Parts:
J16: Micro_SD_Card; mem2051

Connections:
/EFM32/SD_SPI_CLK: J16.5 (CLK); also elsewhere on the board
/EFM32/SD_SPI_CS: J16.2 (DAT3/CD); also elsewhere on the board
/EFM32/SD_SPI_EFM0: J16.3 (CMD); also elsewhere on the board
/EFM32/SD_SPI_EFM1: J16.7 (DAT0); also elsewhere on the board
GND: J16.6 (VSS), J16.8 (DAT1), J16.9 (SHIELD); also elsewhere on the board

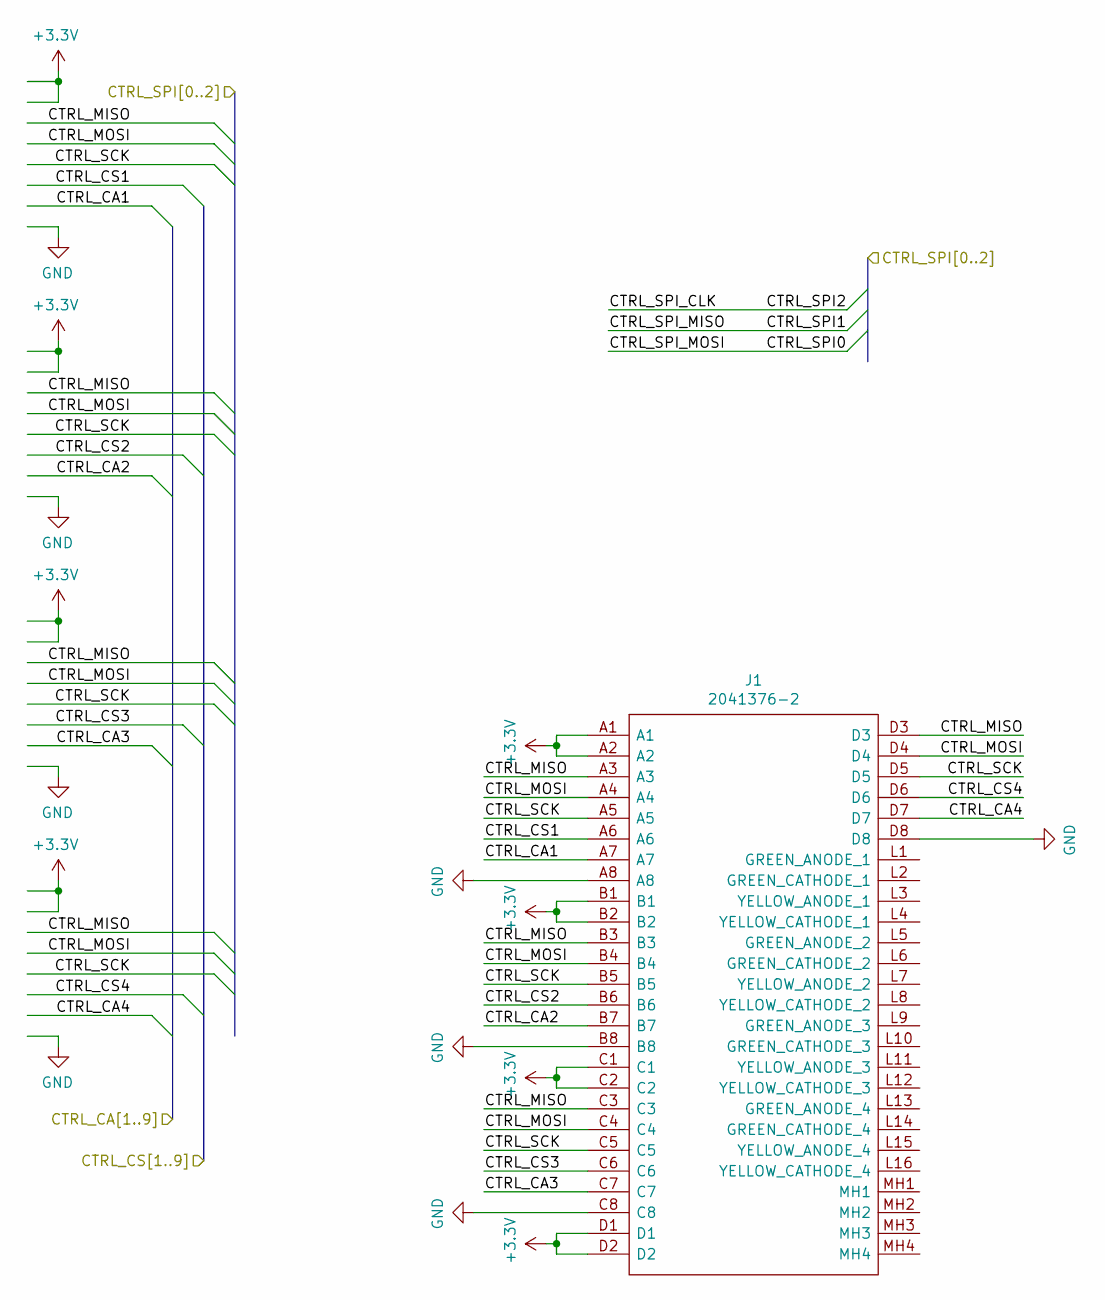
[picture p26: schematic Controller.sch]

Parts:
J1: 2041376-2; 20413762; Mouser Part Number 571-2041376-2

Connections:
/Controller/CTRL_CA1: J1.A7; also elsewhere on the board
/Controller/CTRL_CA2: J1.B7; also elsewhere on the board
/Controller/CTRL_CA3: J1.C7; also elsewhere on the board
/Controller/CTRL_CA4: J1.D7; also elsewhere on the board
/Controller/CTRL_CS1: J1.A6; also elsewhere on the board
/Controller/CTRL_CS2: J1.B6; also elsewhere on the board
/Controller/CTRL_CS3: J1.C6; also elsewhere on the board
/Controller/CTRL_CS4: J1.D6; also elsewhere on the board
/Controller/CTRL_MISO: J1.A3, J1.B3, J1.C3, J1.D3
/Controller/CTRL_MOSI: J1.A4, J1.B4, J1.C4, J1.D4
/Controller/CTRL_SCK: J1.A5, J1.B5, J1.C5, J1.D5
GND: J1.A8, J1.B8, J1.C8, J1.D8; also elsewhere on the board

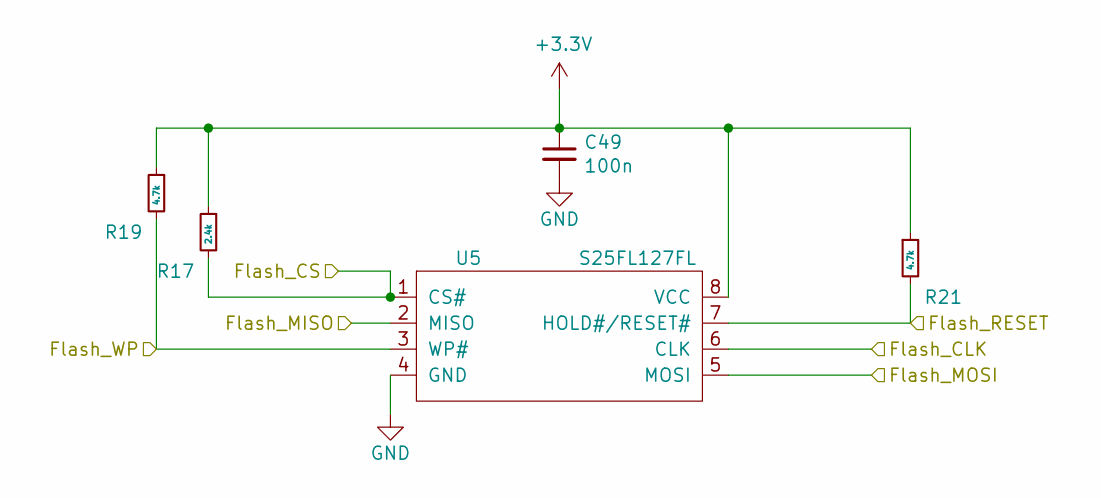
[picture p27: schematic Flash_SPI.sch]

Parts:
C49: 100n; C_0805_2012Metric
R17: 2.4k; R_0805_2012Metric
R19, R21: 4.7k; R_0805_2012Metric
U5: S25FL127FL; SOIC-8_5.275x5.275mm_P1.27mm

Connections:
/FPGA/Flash_CLK: U5.6 (CLK); also elsewhere on the board
/FPGA/Flash_CS: R17.2, U5.1 (CS#); also elsewhere on the board
/FPGA/Flash_MISO: U5.2 (MISO); also elsewhere on the board
/FPGA/Flash_MOSI: U5.5 (MOSI); also elsewhere on the board
/FPGA/Flash_RESET: R21.2, U5.7 (HOLD#/RESET#); also elsewhere on the board
/FPGA/Flash_WP: R19.2, U5.3 (WP#); also elsewhere on the board
GND: C49.2, U5.4 (GND); also elsewhere on the board

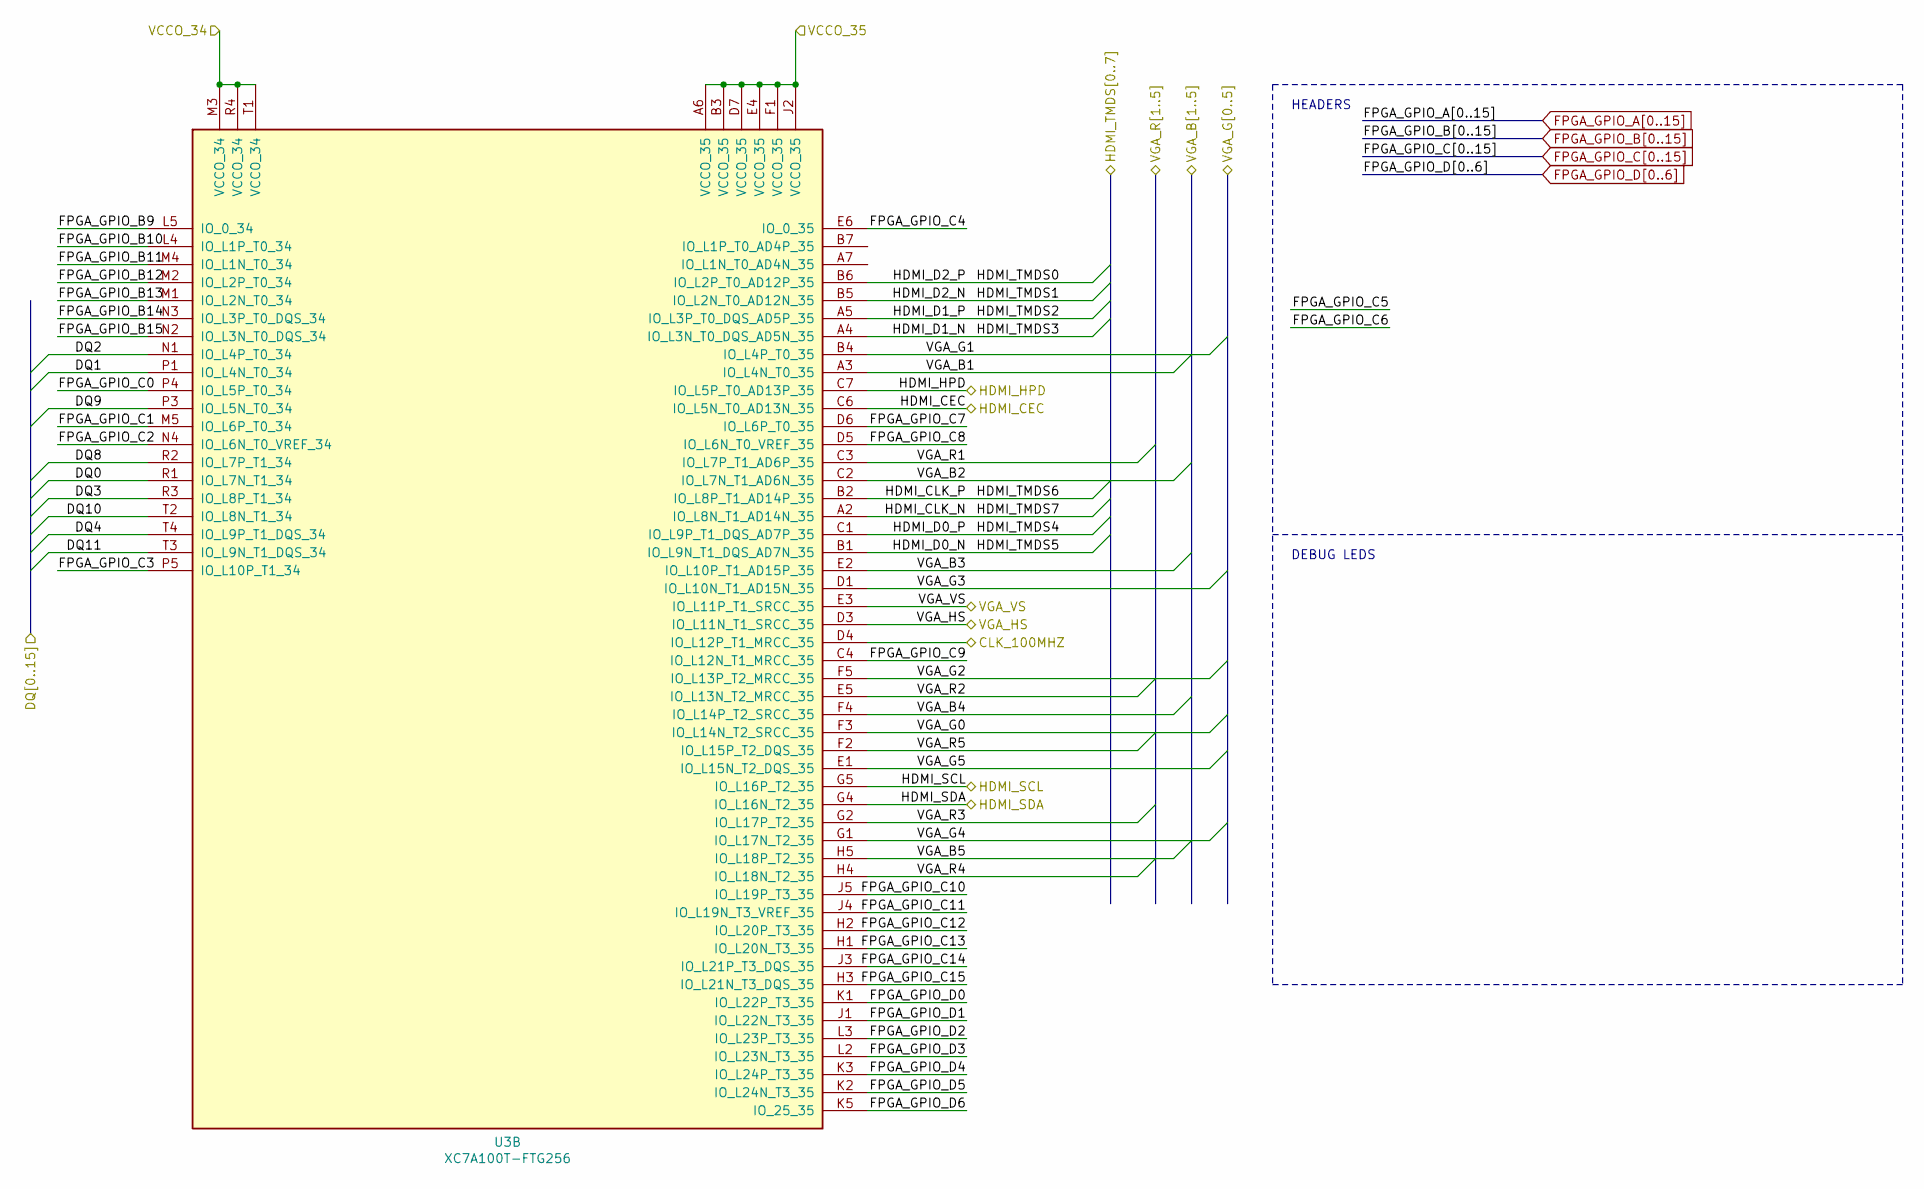
[picture p28: schematic FPGA_UnitB.sch]

Parts:
U3: XC7A100T-FTG256; Xilinx_FTG256

Connections:
/FPGA/FPGA_UnitB/CLK_100MHZ: U3.D4 (IO_L12P_T1_MRCC_35); also elsewhere on the board
/FPGA/FPGA_UnitB/DQ0: U3.R1 (IO_L7N_T1_34)
/FPGA/FPGA_UnitB/DQ1: U3.P1 (IO_L4N_T0_34)
/FPGA/FPGA_UnitB/DQ2: U3.N1 (IO_L4P_T0_34)
/FPGA/FPGA_UnitB/DQ3: U3.R3 (IO_L8P_T1_34)
/FPGA/FPGA_UnitB/DQ4: U3.T4 (IO_L9P_T1_DQS_34)
/FPGA/FPGA_UnitB/DQ8: U3.R2 (IO_L7P_T1_34)
/FPGA/FPGA_UnitB/DQ9: U3.P3 (IO_L5N_T0_34)
/FPGA/FPGA_UnitB/DQ10: U3.T2 (IO_L8N_T1_34)
/FPGA/FPGA_UnitB/DQ11: U3.T3 (IO_L9N_T1_DQS_34)
/FPGA/HDMI_CEC: U3.C6 (IO_L5N_T0_AD13N_35); also elsewhere on the board
/FPGA/HDMI_HPD: U3.C7 (IO_L5P_T0_AD13P_35); also elsewhere on the board
/FPGA/HDMI_SCL: U3.G5 (IO_L16P_T2_35); also elsewhere on the board
/FPGA/HDMI_SDA: U3.G4 (IO_L16N_T2_35); also elsewhere on the board
/FPGA/VGA_HS: U3.D3 (IO_L11N_T1_SRCC_35); also elsewhere on the board
/FPGA/VGA_VS: U3.E3 (IO_L11P_T1_SRCC_35); also elsewhere on the board
/HDMI/HDMI_CK_N: U3.A2 (IO_L8N_T1_AD14N_35); also elsewhere on the board
/HDMI/HDMI_CK_P: U3.B2 (IO_L8P_T1_AD14P_35); also elsewhere on the board
/HDMI/HDMI_D0_N: U3.B1 (IO_L9N_T1_DQS_AD7N_35); also elsewhere on the board
/HDMI/HDMI_D0_P: U3.C1 (IO_L9P_T1_DQS_AD7P_35); also elsewhere on the board
/HDMI/HDMI_D1_N: U3.A4 (IO_L3N_T0_DQS_AD5N_35); also elsewhere on the board
/HDMI/HDMI_D1_P: U3.A5 (IO_L3P_T0_DQS_AD5P_35); also elsewhere on the board
/HDMI/HDMI_D2_N: U3.B5 (IO_L2N_T0_AD12N_35); also elsewhere on the board
/HDMI/HDMI_D2_P: U3.B6 (IO_L2P_T0_AD12P_35); also elsewhere on the board
/VGA/VGA_B1: U3.A3 (IO_L4N_T0_35); also elsewhere on the board
/VGA/VGA_B2: U3.C2 (IO_L7N_T1_AD6N_35); also elsewhere on the board
/VGA/VGA_B3: U3.E2 (IO_L10P_T1_AD15P_35); also elsewhere on the board
/VGA/VGA_B4: U3.F4 (IO_L14P_T2_SRCC_35); also elsewhere on the board
/VGA/VGA_B5: U3.H5 (IO_L18P_T2_35); also elsewhere on the board
/VGA/VGA_G0: U3.F3 (IO_L14N_T2_SRCC_35); also elsewhere on the board
/VGA/VGA_G1: U3.B4 (IO_L4P_T0_35); also elsewhere on the board
/VGA/VGA_G2: U3.F5 (IO_L13P_T2_MRCC_35); also elsewhere on the board
/VGA/VGA_G3: U3.D1 (IO_L10N_T1_AD15N_35); also elsewhere on the board
/VGA/VGA_G4: U3.G1 (IO_L17N_T2_35); also elsewhere on the board
/VGA/VGA_G5: U3.E1 (IO_L15N_T2_DQS_35); also elsewhere on the board
/VGA/VGA_R1: U3.C3 (IO_L7P_T1_AD6P_35); also elsewhere on the board
/VGA/VGA_R2: U3.E5 (IO_L13N_T2_MRCC_35); also elsewhere on the board
/VGA/VGA_R3: U3.G2 (IO_L17P_T2_35); also elsewhere on the board
/VGA/VGA_R4: U3.H4 (IO_L18N_T2_35); also elsewhere on the board
/VGA/VGA_R5: U3.F2 (IO_L15P_T2_DQS_35); also elsewhere on the board
FPGA_GPIO_B9: U3.L5 (IO_0_34); also elsewhere on the board
FPGA_GPIO_B10: U3.L4 (IO_L1P_T0_34); also elsewhere on the board
FPGA_GPIO_B11: U3.M4 (IO_L1N_T0_34); also elsewhere on the board
FPGA_GPIO_B12: U3.M2 (IO_L2P_T0_34); also elsewhere on the board
FPGA_GPIO_B13: U3.M1 (IO_L2N_T0_34); also elsewhere on the board
FPGA_GPIO_B14: U3.N3 (IO_L3P_T0_DQS_34); also elsewhere on the board
FPGA_GPIO_B15: U3.N2 (IO_L3N_T0_DQS_34); also elsewhere on the board
FPGA_GPIO_C0: U3.P4 (IO_L5P_T0_34); also elsewhere on the board
FPGA_GPIO_C1: U3.M5 (IO_L6P_T0_34); also elsewhere on the board
FPGA_GPIO_C2: U3.N4 (IO_L6N_T0_VREF_34); also elsewhere on the board
FPGA_GPIO_C3: U3.P5 (IO_L10P_T1_34); also elsewhere on the board
FPGA_GPIO_C4: U3.E6 (IO_0_35); also elsewhere on the board
FPGA_GPIO_C7: U3.D6 (IO_L6P_T0_35); also elsewhere on the board
FPGA_GPIO_C8: U3.D5 (IO_L6N_T0_VREF_35); also elsewhere on the board
FPGA_GPIO_C9: U3.C4 (IO_L12N_T1_MRCC_35); also elsewhere on the board
FPGA_GPIO_C10: U3.J5 (IO_L19P_T3_35)
FPGA_GPIO_C11: U3.J4 (IO_L19N_T3_VREF_35)
FPGA_GPIO_C12: U3.H2 (IO_L20P_T3_35); also elsewhere on the board
FPGA_GPIO_C13: U3.H1 (IO_L20N_T3_35)
FPGA_GPIO_C14: U3.J3 (IO_L21P_T3_DQS_35); also elsewhere on the board
FPGA_GPIO_C15: U3.H3 (IO_L21N_T3_DQS_35); also elsewhere on the board
FPGA_GPIO_D0: U3.K1 (IO_L22P_T3_35)
FPGA_GPIO_D1: U3.J1 (IO_L22N_T3_35)
FPGA_GPIO_D2: U3.L3 (IO_L23P_T3_35); also elsewhere on the board
FPGA_GPIO_D3: U3.L2 (IO_L23N_T3_35); also elsewhere on the board
FPGA_GPIO_D4: U3.K3 (IO_L24P_T3_35); also elsewhere on the board
FPGA_GPIO_D5: U3.K2 (IO_L24N_T3_35)
FPGA_GPIO_D6: U3.K5 (IO_25_35)

Notes on the sheet:
HEADERS
DEBUG LEDS
