datamaskinprojektet/PCB/main_schematic/main_schematic.kicad_pcb

## KiCad design main_schematic/main_schematic.kicad_pcb (continued)

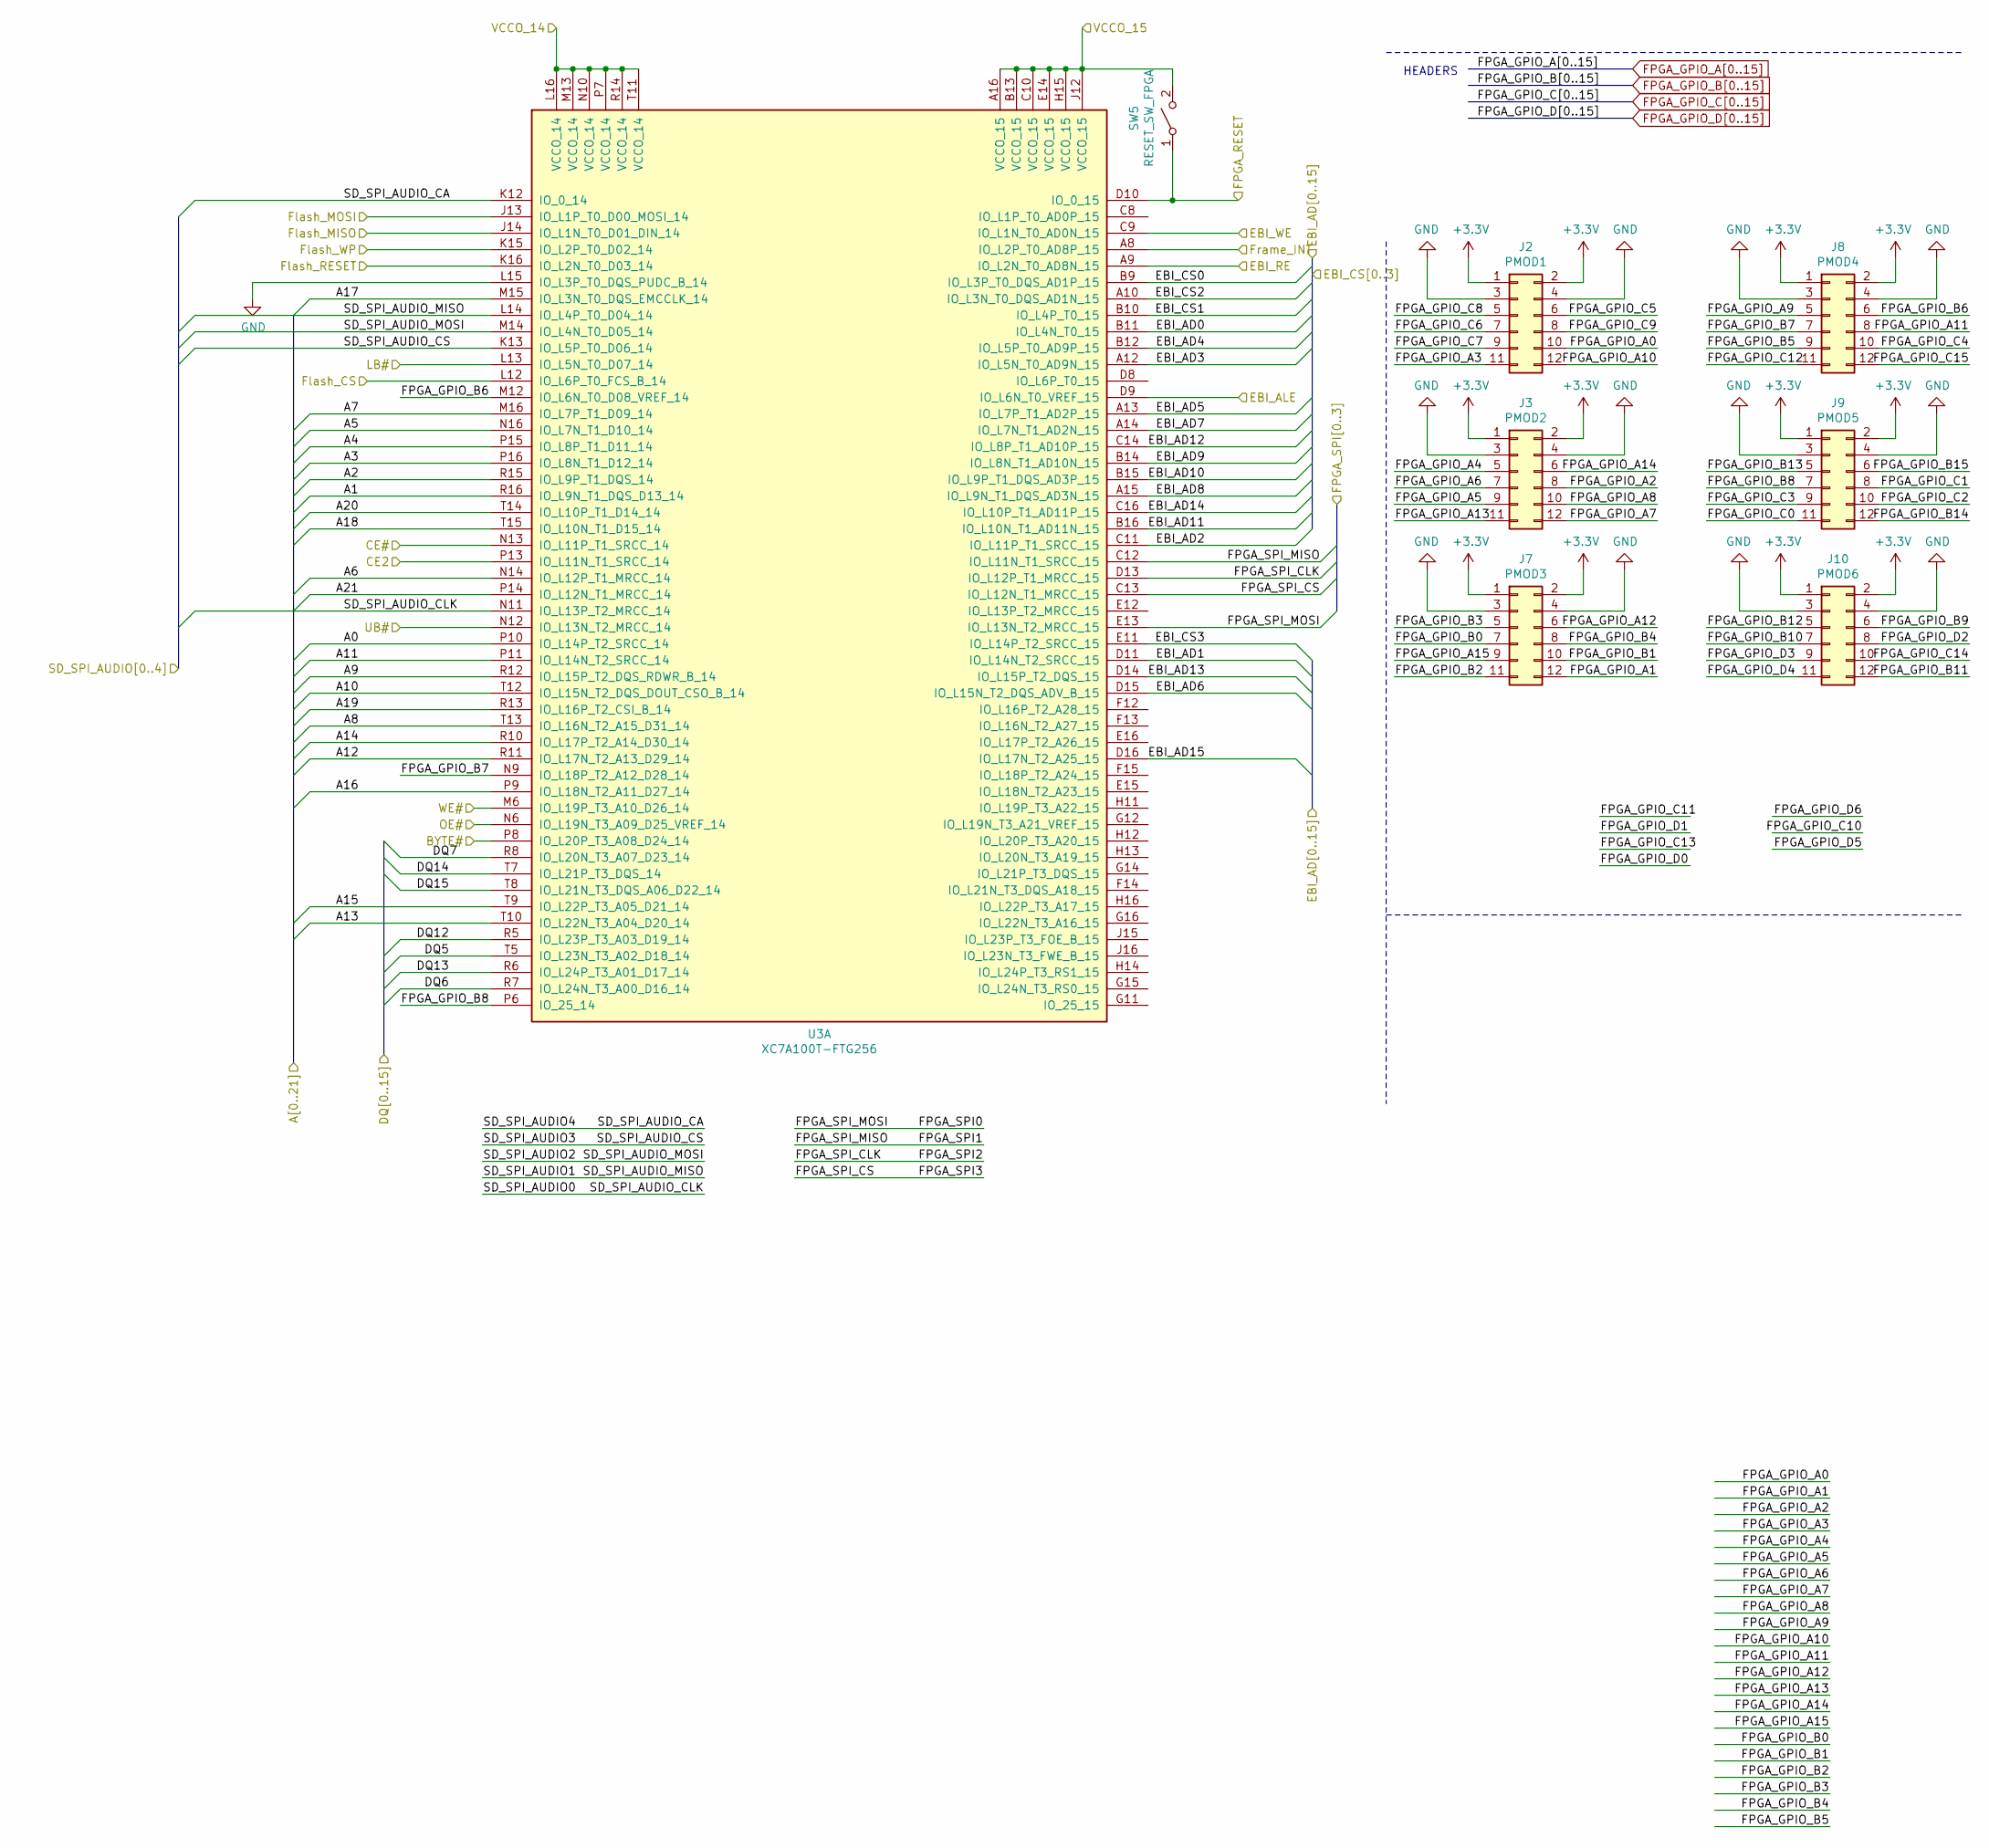
[picture p29: schematic FPGA_UnitA.sch]

Parts:
J2: PMOD1; SMH10602LD
J3: PMOD2; SMH10602LD
J7: PMOD3; SMH10602LD
J8: PMOD4; SMH10602LD
J9: PMOD5; SMH10602LD
J10: PMOD6; SMH10602LD
SW5: RESET_SW_FPGA; SW_SPST_B3S-1000
U3: XC7A100T-FTG256; Xilinx_FTG256

Connections:
/EBI_ALE: U3.D9 (IO_L6N_T0_VREF_15); also elsewhere on the board
/EBI_RE: U3.A9 (IO_L2N_T0_AD8N_15); also elsewhere on the board
/EBI_WE: U3.C9 (IO_L1N_T0_AD0N_15); also elsewhere on the board
/EFM32/EBI_AD4: U3.B12 (IO_L5P_T0_AD9P_15); also elsewhere on the board
/EFM32/EBI_AD5: U3.A13 (IO_L7P_T1_AD2P_15); also elsewhere on the board
/EFM32/EBI_AD6: U3.D15 (IO_L15N_T2_DQS_ADV_B_15); also elsewhere on the board
/EFM32/EBI_AD7: U3.A14 (IO_L7N_T1_AD2N_15); also elsewhere on the board
/EFM32/EBI_AD8: U3.A15 (IO_L9N_T1_DQS_AD3N_15); also elsewhere on the board
/EFM32/EBI_AD9: U3.B14 (IO_L8N_T1_AD10N_15); also elsewhere on the board
/EFM32/EBI_AD10: U3.B15 (IO_L9P_T1_DQS_AD3P_15); also elsewhere on the board
/EFM32/EBI_AD11: U3.B16 (IO_L10N_T1_AD11N_15); also elsewhere on the board
/EFM32/EBI_AD12: U3.C14 (IO_L8P_T1_AD10P_15); also elsewhere on the board
/EFM32/EBI_AD13: U3.D14 (IO_L15P_T2_DQS_15); also elsewhere on the board
/EFM32/EBI_AD14: U3.C16 (IO_L10P_T1_AD11P_15); also elsewhere on the board
/EFM32/EBI_AD15: U3.D16 (IO_L17N_T2_A25_15); also elsewhere on the board
/EFM32/FPGA_SPI0: U3.E13 (IO_L13N_T2_MRCC_15); also elsewhere on the board
/EFM32/FPGA_SPI1: U3.C12 (IO_L11N_T1_SRCC_15); also elsewhere on the board
/EFM32/FPGA_SPI2: U3.D13 (IO_L12P_T1_MRCC_15); also elsewhere on the board
/EFM32/FPGA_SPI3: U3.C13 (IO_L12N_T1_MRCC_15); also elsewhere on the board
/FPGA/BYTE#: U3.P8 (IO_L20P_T3_A08_D24_14)
/FPGA/CE2: U3.P13 (IO_L11N_T1_SRCC_14)
/FPGA/CE#: U3.N13 (IO_L11P_T1_SRCC_14)
/FPGA/FPGA_UnitA/A0: U3.P10 (IO_L14P_T2_SRCC_14)
/FPGA/FPGA_UnitA/A1: U3.R16 (IO_L9N_T1_DQS_D13_14)
/FPGA/FPGA_UnitA/A2: U3.R15 (IO_L9P_T1_DQS_14)
/FPGA/FPGA_UnitA/A3: U3.P16 (IO_L8N_T1_D12_14)
/FPGA/FPGA_UnitA/A4: U3.P15 (IO_L8P_T1_D11_14)
/FPGA/FPGA_UnitA/A5: U3.N16 (IO_L7N_T1_D10_14)
/FPGA/FPGA_UnitA/A6: U3.N14 (IO_L12P_T1_MRCC_14)
/FPGA/FPGA_UnitA/A7: U3.M16 (IO_L7P_T1_D09_14)
/FPGA/FPGA_UnitA/A8: U3.T13 (IO_L16N_T2_A15_D31_14)
/FPGA/FPGA_UnitA/A9: U3.R12 (IO_L15P_T2_DQS_RDWR_B_14)
/FPGA/FPGA_UnitA/A10: U3.T12 (IO_L15N_T2_DQS_DOUT_CSO_B_14)
/FPGA/FPGA_UnitA/A11: U3.P11 (IO_L14N_T2_SRCC_14)
/FPGA/FPGA_UnitA/A12: U3.R11 (IO_L17N_T2_A13_D29_14)
/FPGA/FPGA_UnitA/A13: U3.T10 (IO_L22N_T3_A04_D20_14)
/FPGA/FPGA_UnitA/A14: U3.R10 (IO_L17P_T2_A14_D30_14)
/FPGA/FPGA_UnitA/A15: U3.T9 (IO_L22P_T3_A05_D21_14)
/FPGA/FPGA_UnitA/A16: U3.P9 (IO_L18N_T2_A11_D27_14)
/FPGA/FPGA_UnitA/A17: U3.M15 (IO_L3N_T0_DQS_EMCCLK_14)
/FPGA/FPGA_UnitA/A18: U3.T15 (IO_L10N_T1_D15_14)
/FPGA/FPGA_UnitA/A19: U3.R13 (IO_L16P_T2_CSI_B_14)
/FPGA/FPGA_UnitA/A20: U3.T14 (IO_L10P_T1_D14_14)
/FPGA/FPGA_UnitA/A21: U3.P14 (IO_L12N_T1_MRCC_14)
/FPGA/FPGA_UnitA/DQ5: U3.T5 (IO_L23N_T3_A02_D18_14)
/FPGA/FPGA_UnitA/DQ6: U3.R7 (IO_L24N_T3_A00_D16_14)
/FPGA/FPGA_UnitA/DQ7: U3.R8 (IO_L20N_T3_A07_D23_14)
/FPGA/FPGA_UnitA/DQ12: U3.R5 (IO_L23P_T3_A03_D19_14)
/FPGA/FPGA_UnitA/DQ13: U3.R6 (IO_L24P_T3_A01_D17_14)
/FPGA/FPGA_UnitA/DQ14: U3.T7 (IO_L21P_T3_DQS_14)
/FPGA/FPGA_UnitA/DQ15: U3.T8 (IO_L21N_T3_DQS_A06_D22_14)
/FPGA/FPGA_UnitA/SD_SPI_AUDIO0: U3.N11 (IO_L13P_T2_MRCC_14)
/FPGA/FPGA_UnitA/SD_SPI_AUDIO1: U3.L14 (IO_L4P_T0_D04_14)
/FPGA/FPGA_UnitA/SD_SPI_AUDIO2: U3.M14 (IO_L4N_T0_D05_14)
/FPGA/FPGA_UnitA/SD_SPI_AUDIO3: U3.K13 (IO_L5P_T0_D06_14)
/FPGA/FPGA_UnitA/SD_SPI_AUDIO4: U3.K12 (IO_0_14)
/FPGA/Flash_CS: U3.L12 (IO_L6P_T0_FCS_B_14); also elsewhere on the board
/FPGA/Flash_MISO: U3.J14 (IO_L1N_T0_D01_DIN_14); also elsewhere on the board
/FPGA/Flash_MOSI: U3.J13 (IO_L1P_T0_D00_MOSI_14); also elsewhere on the board
/FPGA/Flash_RESET: U3.K16 (IO_L2N_T0_D03_14); also elsewhere on the board
/FPGA/Flash_WP: U3.K15 (IO_L2P_T0_D02_14); also elsewhere on the board
/FPGA/LB#: U3.L13 (IO_L5N_T0_D07_14)
/FPGA/OE#: U3.N6 (IO_L19N_T3_A09_D25_VREF_14)
/FPGA/UB#: U3.N12 (IO_L13N_T2_MRCC_14)
/FPGA/WE#: U3.M6 (IO_L19P_T3_A10_D26_14)
/FPGA_RESET: SW5.1 (A), U3.D10 (IO_0_15); also elsewhere on the board
/Frame_INT: U3.A8 (IO_L2P_T0_AD8P_15); also elsewhere on the board
FPGA_GPIO_A0: J2.10
FPGA_GPIO_A1: J7.12
FPGA_GPIO_A2: J3.8
FPGA_GPIO_A3: J2.11
FPGA_GPIO_A4: J3.5
FPGA_GPIO_A5: J3.9
FPGA_GPIO_A6: J3.7
FPGA_GPIO_A7: J3.12
FPGA_GPIO_A8: J3.10
FPGA_GPIO_A9: J8.5
FPGA_GPIO_A10: J2.12
FPGA_GPIO_A11: J8.8
FPGA_GPIO_A12: J7.6
FPGA_GPIO_A13: J3.11
FPGA_GPIO_A14: J3.6
FPGA_GPIO_A15: J7.9
FPGA_GPIO_B0: J7.7
FPGA_GPIO_B1: J7.10
FPGA_GPIO_B2: J7.11
FPGA_GPIO_B3: J7.5
FPGA_GPIO_B4: J7.8
FPGA_GPIO_B5: J8.9
FPGA_GPIO_B6: J8.6, U3.M12 (IO_L6N_T0_D08_VREF_14)
FPGA_GPIO_B7: J8.7, U3.N9 (IO_L18P_T2_A12_D28_14)
FPGA_GPIO_B8: J9.7, U3.P6 (IO_25_14)
FPGA_GPIO_B9: J10.6; also elsewhere on the board
FPGA_GPIO_B10: J10.7; also elsewhere on the board
FPGA_GPIO_B11: J10.12; also elsewhere on the board
FPGA_GPIO_B12: J10.5; also elsewhere on the board
FPGA_GPIO_B13: J9.5; also elsewhere on the board
FPGA_GPIO_B14: J9.12; also elsewhere on the board
FPGA_GPIO_B15: J9.6; also elsewhere on the board
FPGA_GPIO_C0: J9.11; also elsewhere on the board
FPGA_GPIO_C1: J9.8; also elsewhere on the board
FPGA_GPIO_C2: J9.10; also elsewhere on the board
FPGA_GPIO_C3: J9.9; also elsewhere on the board
FPGA_GPIO_C4: J8.10; also elsewhere on the board
FPGA_GPIO_C5: J2.6
FPGA_GPIO_C6: J2.7
FPGA_GPIO_C7: J2.9; also elsewhere on the board
FPGA_GPIO_C8: J2.5; also elsewhere on the board
FPGA_GPIO_C9: J2.8; also elsewhere on the board
FPGA_GPIO_C12: J8.11; also elsewhere on the board
FPGA_GPIO_C14: J10.10; also elsewhere on the board
FPGA_GPIO_C15: J8.12; also elsewhere on the board
FPGA_GPIO_D2: J10.8; also elsewhere on the board
FPGA_GPIO_D3: J10.9; also elsewhere on the board
FPGA_GPIO_D4: J10.11; also elsewhere on the board
GND: J2.3, J2.4, J3.3, J3.4, J7.3, J7.4, J8.3, J8.4, J9.3, J9.4, J10.3, J10.4, U3.L15 (IO_L3P_T0_DQS_PUDC_B_14); also elsewhere on the board

Notes on the sheet:
HEADERS

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
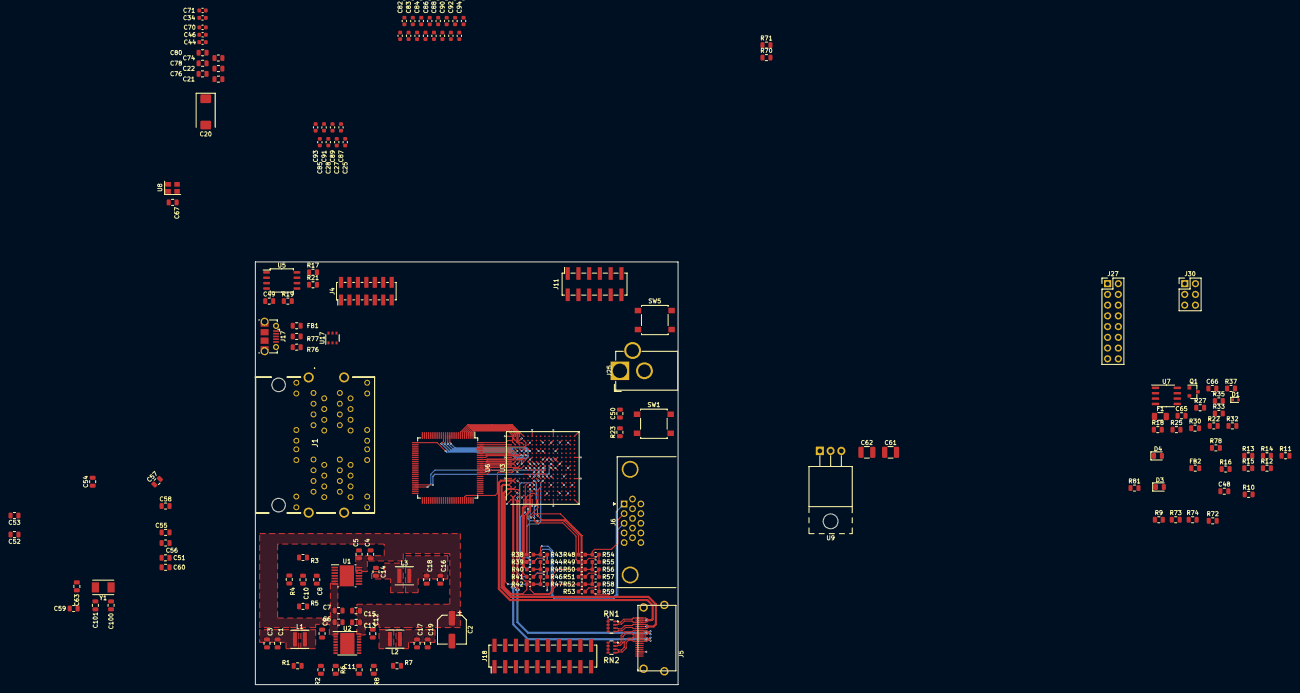
[picture p30: board main_schematic.kicad_pcb from above]

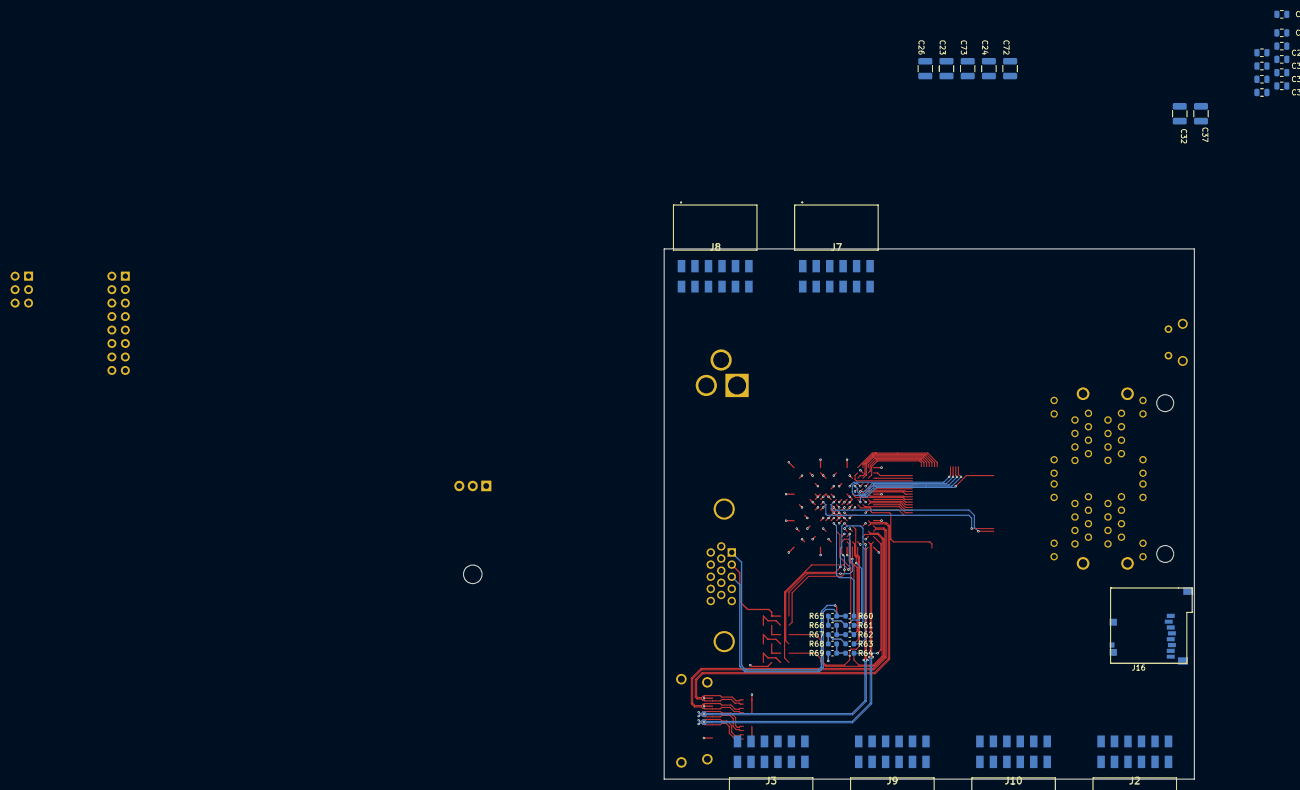
[picture p31: board main_schematic.kicad_pcb from below]

Board: 6 copper layers, 100.0 x 100.0 mm, 204 parts (34 on the bottom side), 196 nets.
