datamaskinprojektet/PCB/Controller/Controller/Controller.kicad_pcb

## KiCad design Controller/Controller/Controller.kicad_pcb (2020-11-24)

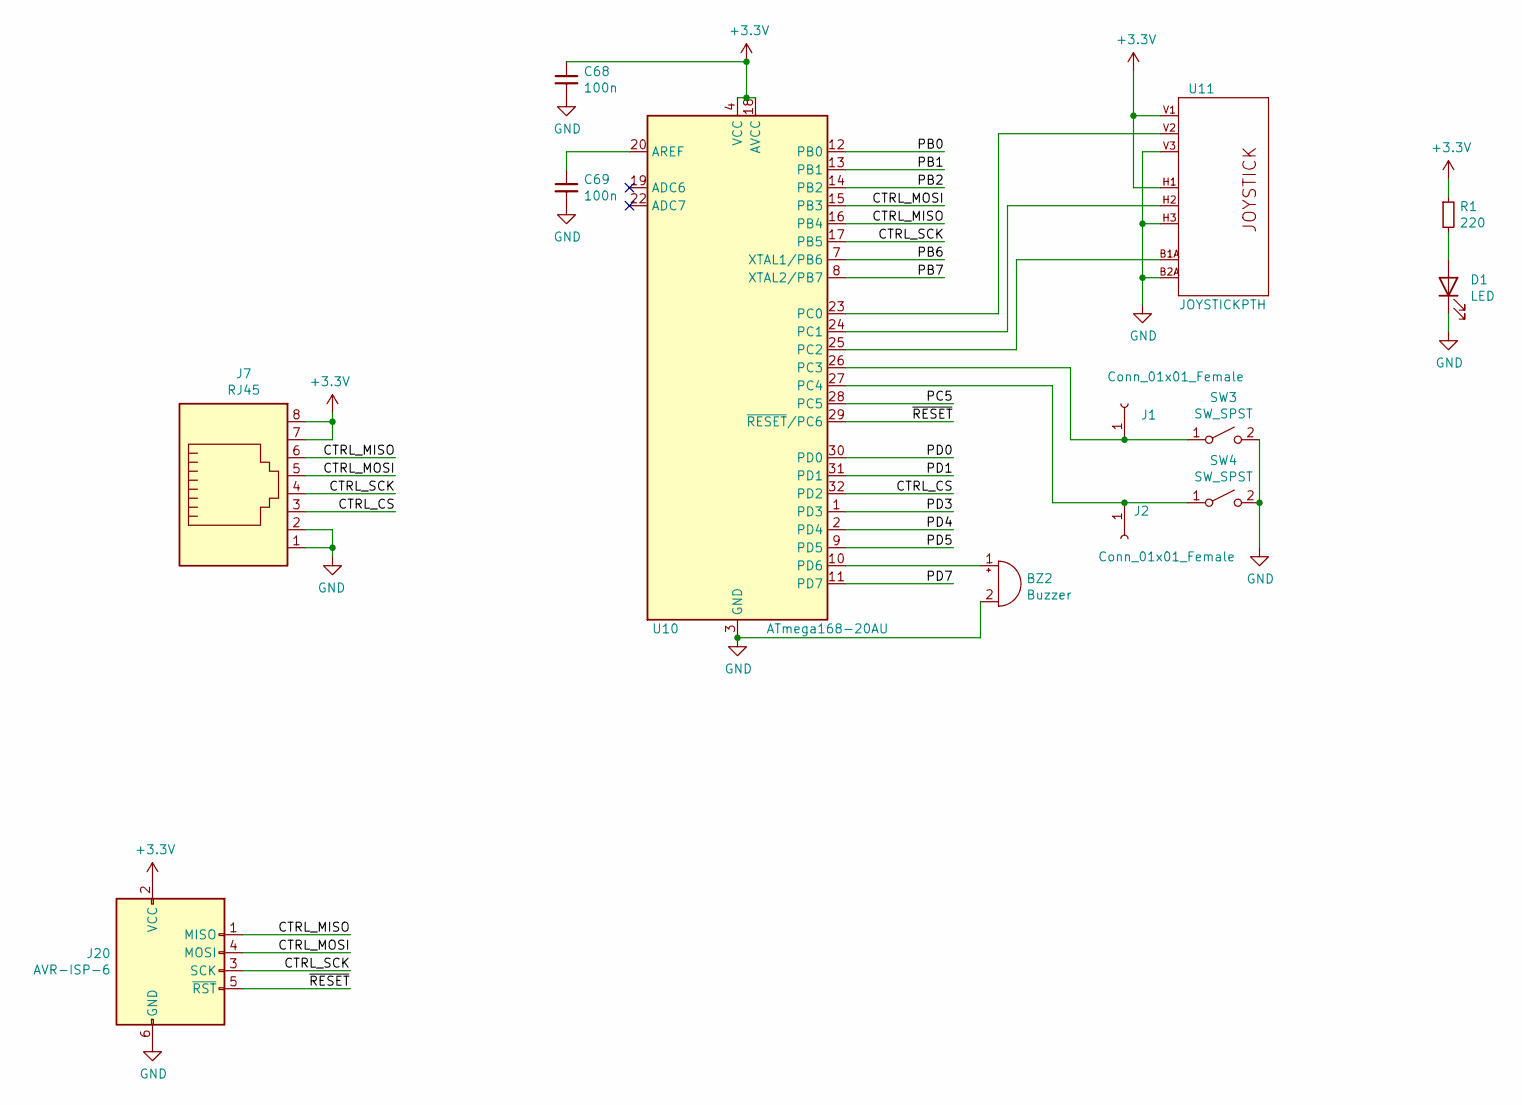
[picture p32: schematic Controller.sch]

Parts:
BZ2: Buzzer; Buzzer_12x9.5RM7.6
C68, C69: 100n; C_0805_2012Metric
D1: LED; LED_D5.0mm
J1, J2: Conn_01x01_Female; PinHeader_1x01_P2.54mm_Vertical
J7: RJ45; RJ45_Amphenol_54602-x08_Horizontal
J20: AVR-ISP-6; IDC-Header_2x03_P2.54mm_Vertical
R1: 220; R_0805_2012Metric
SW3, SW4: SW_SPST; SW_SPST_B3S-1000
U10: ATmega168-20AU; TQFP-32_7x7mm_P0.8mm
U11: JOYSTICKPTH; JOYSTICK

Connections:
+3V3: C68.1, J7.7, J7.8, J20.2 (VCC), R1.1, U10.4 (VCC), U10.6 (VCC), U10.18 (AVCC), U11.H1 (H+), U11.V1 (V+)
/CTRL_CS: J7.3, U10.32 (PD2)
/CTRL_MISO: J7.6, J20.1 (MISO), U10.16 (PB4)
/CTRL_MOSI: J7.5, J20.4 (MOSI), U10.15 (PB3)
/CTRL_SCK: J7.4, J20.3 (SCK), U10.17 (PB5)
/PB0: U10.12 (PB0)
/PB1: U10.13 (PB1)
/PB2: U10.14 (PB2)
/PB6: U10.7 (XTAL1/PB6)
/PB7: U10.8 (XTAL2/PB7)
/PC5: U10.28 (PC5)
/PD0: U10.30 (PD0)
/PD1: U10.31 (PD1)
/PD3: U10.1 (PD3)
/PD4: U10.2 (PD4)
/PD5: U10.9 (PD5)
/PD7: U10.11 (PD7)
/~RESET~: J20.5 (~RST), U10.29 (~RESET~/PC6)
GND: BZ2.2 (+), C68.2, C69.2, D1.1 (K), J7.1, J7.2, J20.6 (GND), SW3.2 (B), SW4.2 (B), U10.3 (GND), U10.5 (GND), U10.21 (GND), U11.B2A (SEL-), U11.H3 (H-), U11.V3 (V-)
unnamed: BZ2.1 (-), U10.10 (PD6)
unnamed: C69.1, U10.20 (AREF)
unnamed: D1.2 (A), R1.2
unnamed: J1.1, SW3.1 (A), U10.26 (PC3)
unnamed: J2.1, SW4.1 (A), U10.27 (PC4)
unnamed: U10.23 (PC0), U11.V2 (V)
unnamed: U10.24 (PC1), U11.H2 (H)
unnamed: U10.25 (PC2), U11.B1A (SEL+)

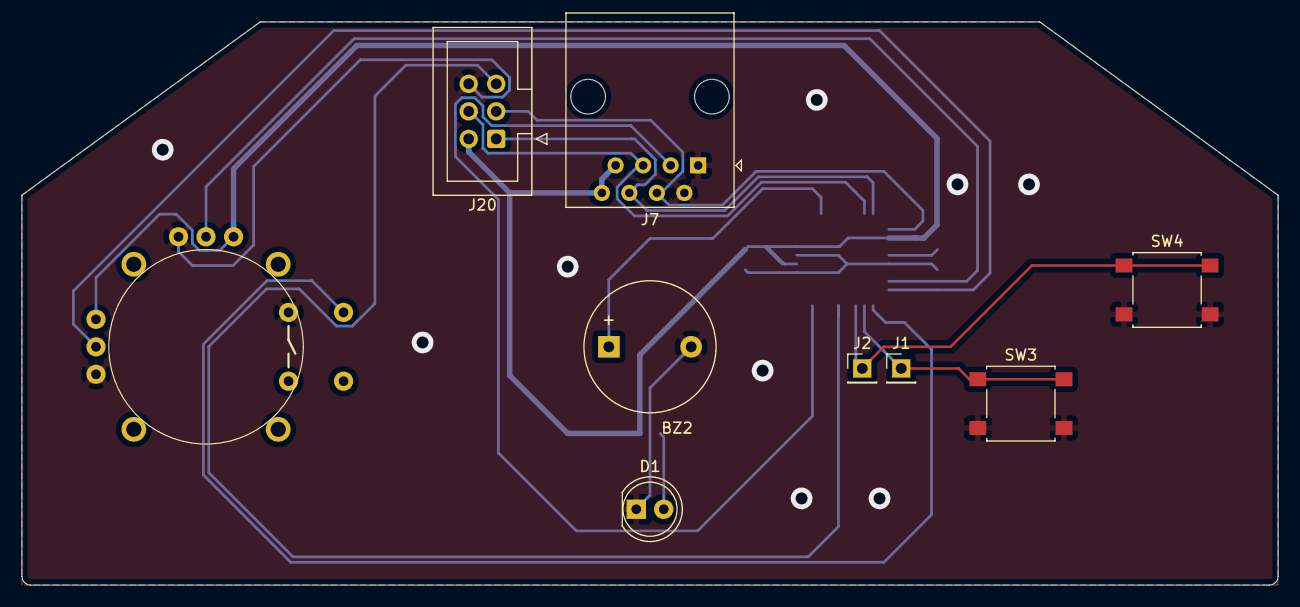
[picture p33: board Controller.kicad_pcb from above]

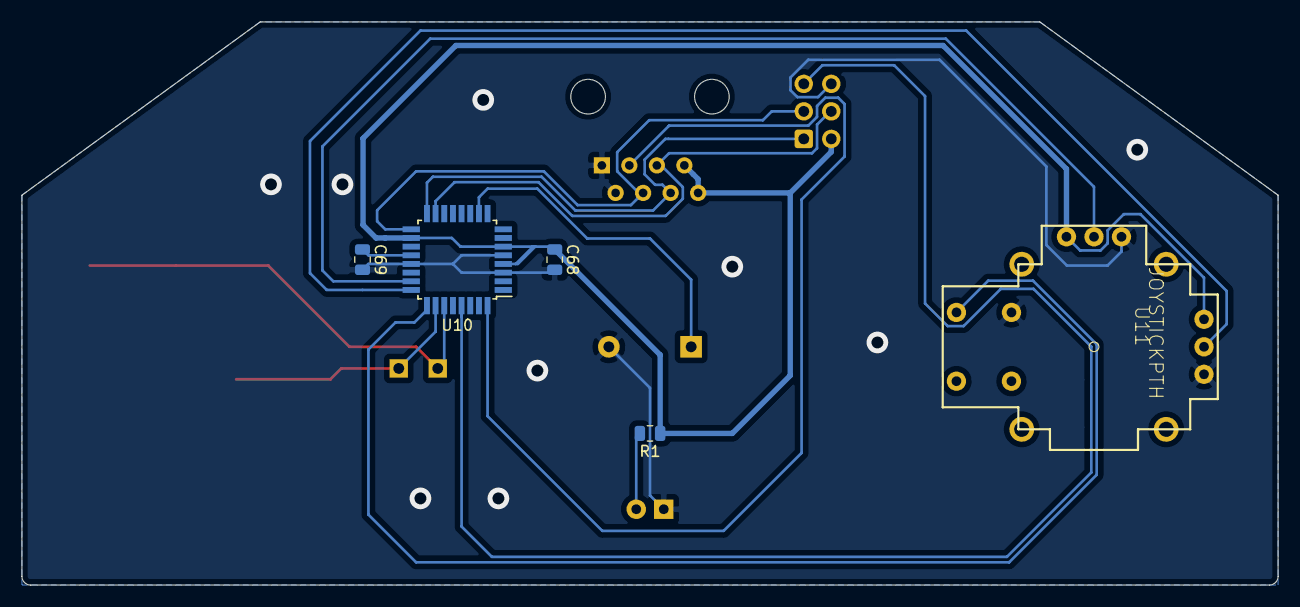
[picture p34: board Controller.kicad_pcb from below]

Board: 2 copper layers, 116.0 x 52.0 mm, 13 parts (4 on the bottom side), 15 nets.
