datamaskinprojektet/PCB/harwareTest/harwareTest.runs/synth_1/.Xil/counter_propImpl.xdc

set_property SRC_FILE_INFO {cfile:C:/Users/Viktor/Documents/Datamaskinprosjektet_PCB/harwareTest/harwareTest.srcs/constrs_1/new/arty.xdc rfile:../../../harwareTest.srcs/constrs_1/new/arty.xdc id:1} [current_design]
set_property src_info {type:XDC file:1 line:11 export:INPUT save:INPUT read:READ} [current_design]
set_property -dict {PACKAGE_PIN E3 IOSTANDARD LVCMOS33} [get_ports {clk}];
set_property src_info {type:XDC file:1 line:21 export:INPUT save:INPUT read:READ} [current_design]
set_property -dict { PACKAGE_PIN E1    IOSTANDARD LVCMOS33 } [get_ports { div_clk }]; #IO_L18N_T2_35 Sch=led0_b
set_property src_info {type:XDC file:1 line:38 export:INPUT save:INPUT read:READ} [current_design]
set_property -dict { PACKAGE_PIN T10   IOSTANDARD LVCMOS33 } [get_ports { div_clk }]; #IO_L24N_T3_A00_D16_14 Sch=led[7]
