datamaskinprojektet/PCB/(commit log)

2020-09-09 Add kicad git sugar
2020-09-13 Add README alongside creating project
    [main_schematic.kicad_pcb, main_schematic.sch]
2020-09-15 Add SMPS schematic
    [PowerSupply.sch]
2020-09-16 Made schematic not have a date
2020-09-17 Added FPGA implimentation without OSC
    [FPGA.sch, FPGA_UnitA.sch, FPGA_UnitB.sch, Flash_SPI.sch, PowerSupply.sch, PowerSupply_LDO.sch, main_schematic.sch]
2020-09-18 Added EFM32 Giant Gecko (lib and sch)
    [EFM32.sch, PowerSupply.sch, main_schematic.sch]
2020-09-18 Fix bak-files not being ignored
    [main_schematic.sch]
2020-09-18 Created schematic symbol for SRAM
    [FPGA.sch, FPGA_UnitA.sch, FPGA_UnitB.sch, Flash_SPI.sch, PowerSupply.sch, PowerSupply_LDO.sch, SRAM.sch, main_schematic.sch]
2020-09-20 Added power circuitry to EFM32
    [EFM32.sch, PowerSupply.sch, PowerSupply_LDO.sch, main_schematic.sch]
2020-09-20 Added separation lines and title. Removed orphaned 3.3v node in the middle of nowhere
    [EFM32.sch, main_schematic.sch]
2020-09-20 Dunno what happened last commit but I need to commit again
    [FPGA.sch, FPGA_UnitA.sch, FPGA_UnitB.sch, Flash_SPI.sch, PowerSupply.sch, PowerSupply_LDO.sch, SRAM.sch]
2020-09-20 Added HDMI
    [EFM32.sch, FPGA.sch, FPGA_UnitA.sch, FPGA_UnitB.sch, Flash_SPI.sch, HDMI.sch, PowerSupply.sch, PowerSupply_LDO.sch]
2020-09-21 Added power flags to power nodes
    [main_schematic.sch]
2020-09-21 Made capacitors on MCU power prettier
    [EFM32.sch, PowerSupply.sch]
2020-09-21 Added PWR_FLAG to 3v3
    [EFM32.sch, main_schematic.sch]
2020-09-21 Changed EFM to use 3.3VA instead of filtering its own power
    [EFM32.sch]
2020-09-21 Added HDMI and VGA support
    [EFM32.sch, FPGA.sch, FPGA_UnitA.sch, FPGA_UnitB.sch, Flash_SPI.sch, HDMI.sch, PowerSupply.sch, PowerSupply_LDO.sch]
2020-09-21 Assigned footprints and Started PCB layout
    [Controller.sch, EFM32.sch, FPGA.sch, FPGA_UnitA.sch, FPGA_UnitB.sch, Flash_SPI.sch, HDMI.sch, PowerSupply.sch]
2020-09-24 Added usb + minor fixes
    [Controller.sch, EFM32.sch, FPGA.sch, FPGA_UnitA.sch, FPGA_UnitB.sch, Flash_SPI.sch, HDMI.sch, PowerSupply.sch]
2020-09-24 Added library for joystick m.m
    [Controller.sch, HDMI.sch]
2020-09-24 Added multiplex option on SD-card and onboard controller
    [Controller.sch, FPGA.sch, FPGA_UnitB.sch, SD_card.sch, main_schematic.sch]
2020-09-25 Fixed minor mistakes and worked on PCB layout
    [AudioControl.sch, Controller.sch, EFM32.sch, FPGA.sch, FPGA_UnitA.sch, FPGA_UnitB.sch, Flash_SPI.sch, HDMI.sch]
2020-09-28 New EFM model and PCB layout in progress
    [AudioControl.sch, Controller.sch, EFM32.sch, FPGA.sch, FPGA_UnitA.sch, FPGA_UnitB.sch, HDMI.sch, SD_card.sch]
2020-09-28 Good progress on routing
    [Controller.sch, EFM32.sch, FPGA.sch, FPGA_UnitA.sch, FPGA_UnitB.sch, Flash_SPI.sch, PowerSupply.sch, main_schematic.kicad_pcb]
2020-09-29 Finished most tracing and changed some bus pins
    [EFM32.sch, FPGA_UnitA.sch, SD_card.sch, main_schematic.kicad_pcb]
2020-09-29 Progress in layout
    [Controller.sch, EFM32.sch, main_schematic.kicad_pcb]
2020-09-29 Gir meg for kvelden
    [AudioControl.sch, Controller.sch, EFM32.sch, FPGA.sch, FPGA_UnitA.sch, SD_card.sch, main_schematic.kicad_pcb, main_schematic.sch]
2020-09-30 Added LDOs to schema
    [FPGA_UnitA.sch, PowerSupply_LDO.sch]
2020-09-30 Annotated schematic
    [PowerSupply_LDO.sch]
2020-09-30 Added capacitors to 5V LDO
    [PowerSupply_LDO.sch]
2020-09-30 Changed MAX8869 LDO to use footprint with EP
2020-09-30 Changed LDO sheet to not use the TI LDO since it has ~EN instead od ~SHDN for some reason. Unusable without an inverter, which I don't feel like making
    [PowerSupply_LDO.sch]
2020-09-30 Wired up the LDOs in eeschema
    [PowerSupply_LDO.sch]
2020-09-30 Added output caps to 1.0, 1.8 and 3.3 volt LDOs
    [PowerSupply_LDO.sch]
2020-09-30 Changed µF to u
    [PowerSupply_LDO.sch, main_schematic.kicad_pcb]
2020-09-30 Complete Schematic
    [AudioControl.sch, Controller.sch, main_schematic.kicad_pcb]
2020-09-30 Fixed ERC errors due to MAX8869 having multiple 'power output' pins
2020-09-30 Moved power supply labels to make it more obvious what they label
    [main_schematic.sch]
2020-09-30 Routed all unused IO pins on the FPGA to headers
    [AudioControl.sch, EFM32.sch, FPGA_UnitA.sch, FPGA_UnitB.sch, SD_card.sch, main_schematic.sch]
2020-09-30 marked SW1 on U1 as not connected
    [PowerSupply.sch]
2020-09-30 Added NC flag to HDMI utility pin
    [HDMI.sch]
2020-09-30 Added power status LEDs to 5V and 3V3
    [main_schematic.sch]
2020-09-30 Finished essensial routing
    [AudioControl.sch, EFM32.sch, PowerSupply_LDO.sch, SD_card.sch, main_schematic.kicad_pcb]
2020-09-30 Fixes one track
    [main_schematic.kicad_pcb]
2020-09-30 marked some pins on VGA connector as NC
    [VGA.sch]
2020-09-30 Added headers to audio MCU. Added 9v barrel jack as power supply connector
    [AudioControl.sch, main_schematic.sch]
2020-09-30 all unused pins are now connected
    [Controller.sch, EFM32.sch]
2020-10-01 Ready for ordering
    [AudioControl.sch, Controller.sch, EFM32.sch, FPGA_UnitA.sch, main_schematic.kicad_pcb, main_schematic.sch]
2020-10-01 Fixed graphics
    [main_schematic.kicad_pcb]
2020-10-01 Fixed mistake
    [EFM32.sch, FPGA_UnitA.sch, main_schematic.kicad_pcb, main_schematic.sch]
2020-10-05 Version 2 for production
    [EFM32.sch, FPGA.sch, Flash_SPI.sch, USB.sch]
2020-11-05 Added KiCAD projects for various extra parts, added different 3d models and a vivado hardware test project
    [BRA stencil.kicad_pcb, BRA stencil.sch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]
2020-11-24 Added FPGA test code and 3d files for printing
    [9032.STEP, Abutton.stl, Bbutton.stl, Controller v4.stl, Controller v5.stl, Controller.kicad_pcb, ControllerBOTTOM.stl, ControllerBetterPrint.stl]
2020-11-24 Started conversion of PCB to smaller card, removed some redundancy
    [AudioControl.sch, Controller.sch, EFM32.sch, FPGA.sch, FPGA_UnitA.sch, FPGA_UnitB.sch, Flash_SPI.sch, HDMI.sch]
2020-11-26 Added new footprints and components
    [Controller.sch, EFM32.sch, FPGA.sch, FPGA_UnitA.sch, Flash_SPI.sch, HDMI.sch, PowerSupply.sch, PowerSupply_LDO.sch]
2020-11-26 Started routing for FPGA
    [Controller.sch, EFM32.sch, FPGA.sch, FPGA_UnitA.sch, FPGA_UnitB.sch, Flash_SPI.sch, HDMI.sch, PowerSupply.sch]
